tollsimy/Analog-Time-Domain-Step-to-Gaussian-Shaping-Filter/Docs/Charge Sensitive Preamplifier _ PhysicsOpenLab_files/ramanSetup_6-310x165.jpg

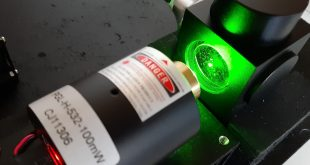
Docs/Charge Sensitive Preamplifier _ PhysicsOpenLab_files/ramanSetup_6-310x165.jpg
