tollsimy/Analog-Time-Domain-Step-to-Gaussian-Shaping-Filter/Docs/Charge Sensitive Preamplifier _ PhysicsOpenLab_files/3778-LfM-Alphaspektrometrie.jpg

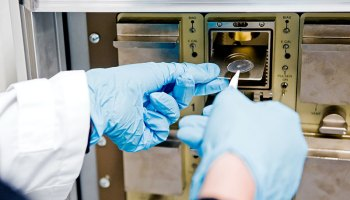
Docs/Charge Sensitive Preamplifier _ PhysicsOpenLab_files/3778-LfM-Alphaspektrometrie.jpg
