tollsimy/Analog-Time-Domain-Step-to-Gaussian-Shaping-Filter/Docs/Charge Sensitive Preamplifier _ PhysicsOpenLab_files/csp2.bmp

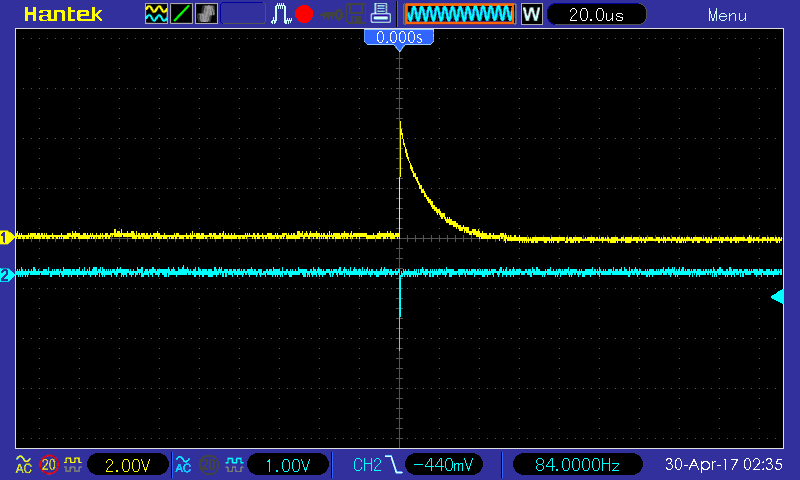
Docs/Charge Sensitive Preamplifier _ PhysicsOpenLab_files/csp2.bmp
