tollsimy/Analog-Time-Domain-Step-to-Gaussian-Shaping-Filter/Docs/Charge Sensitive Preamplifier _ PhysicsOpenLab_files/CSPInput.png

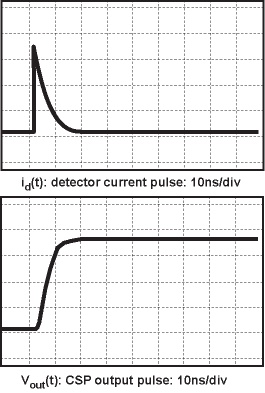
Docs/Charge Sensitive Preamplifier _ PhysicsOpenLab_files/CSPInput.png
