tollsimy/Analog-Time-Domain-Step-to-Gaussian-Shaping-Filter/Docs/Charge Sensitive Preamplifier _ PhysicsOpenLab_files/DEM-OPA-SO-1A.jpg

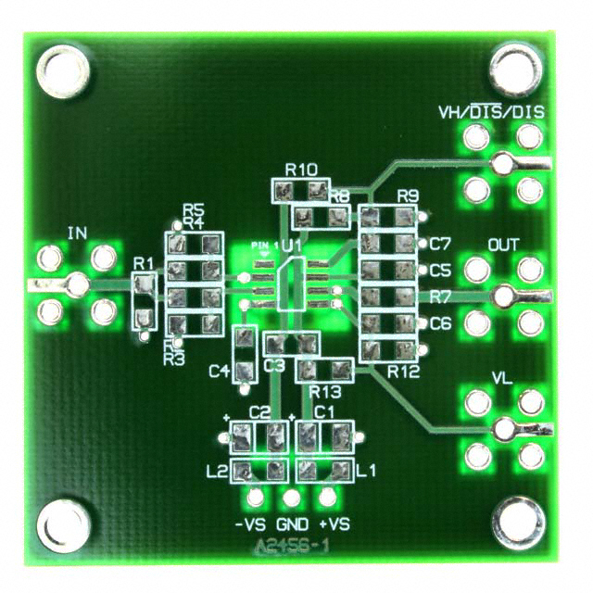
Docs/Charge Sensitive Preamplifier _ PhysicsOpenLab_files/DEM-OPA-SO-1A.jpg
