tollsimy/Analog-Time-Domain-Step-to-Gaussian-Shaping-Filter/Docs/Charge Sensitive Preamplifier _ PhysicsOpenLab_files/IMG_20170415_173511-1024x1012.jpg

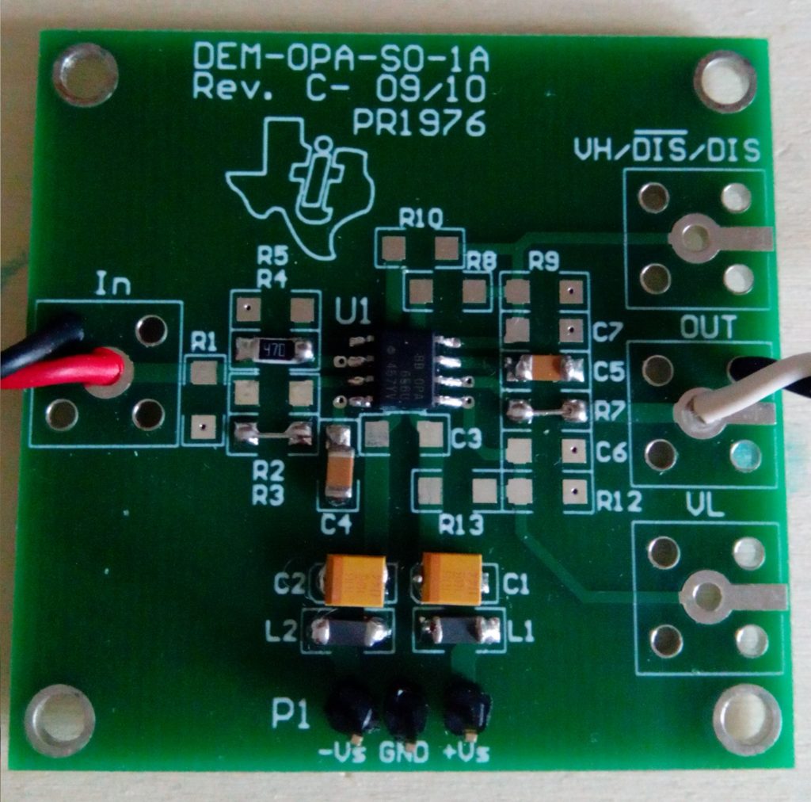
Docs/Charge Sensitive Preamplifier _ PhysicsOpenLab_files/IMG_20170415_173511-1024x1012.jpg
