tollsimy/Analog-Time-Domain-Step-to-Gaussian-Shaping-Filter/Docs/Charge Sensitive Preamplifier _ PhysicsOpenLab_files/IMG_20170427_181501.jpg

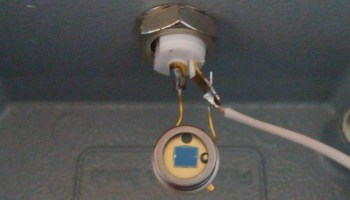
Docs/Charge Sensitive Preamplifier _ PhysicsOpenLab_files/IMG_20170427_181501.jpg
