tollsimy/Analog-Time-Domain-Step-to-Gaussian-Shaping-Filter/Docs/Charge Sensitive Preamplifier _ PhysicsOpenLab_files/IMG_20170617_113114-1024x614.jpg

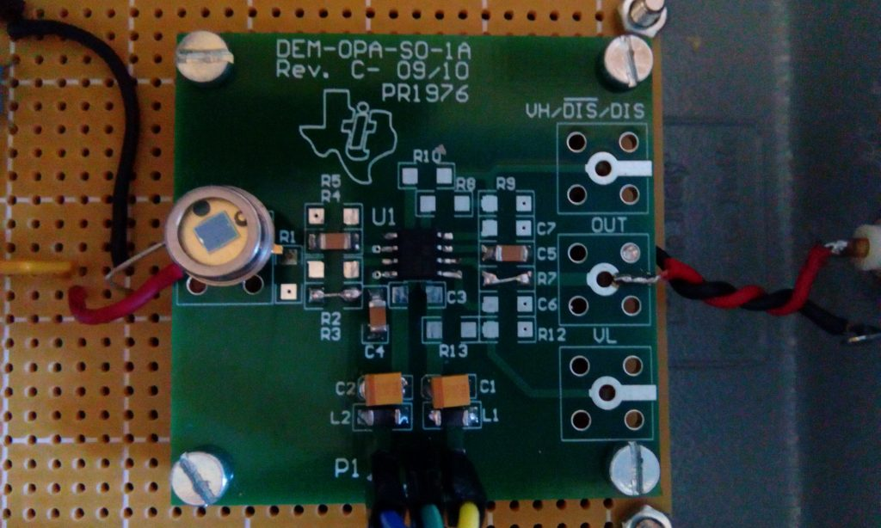
Docs/Charge Sensitive Preamplifier _ PhysicsOpenLab_files/IMG_20170617_113114-1024x614.jpg
