tollsimy/Analog-Time-Domain-Step-to-Gaussian-Shaping-Filter/Docs/Charge Sensitive Preamplifier _ PhysicsOpenLab_files/retroCSP.png

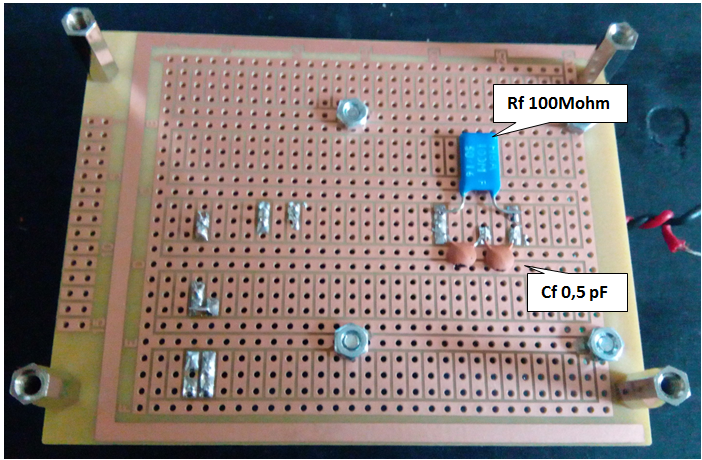
Docs/Charge Sensitive Preamplifier _ PhysicsOpenLab_files/retroCSP.png
