tollsimy/Analog-Time-Domain-Step-to-Gaussian-Shaping-Filter/Docs/Charge sensitive preamplifiers explained – Cremat Inc_files/shaper_effects.jpg

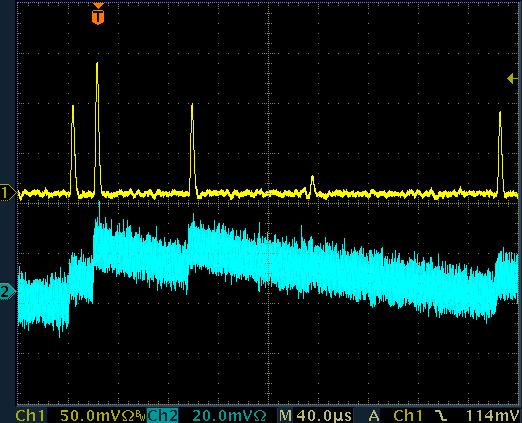
Docs/Charge sensitive preamplifiers explained – Cremat Inc_files/shaper_effects.jpg
