tollsimy/Analog-Time-Domain-Step-to-Gaussian-Shaping-Filter/Pics/IMG_20220221_233307.jpg

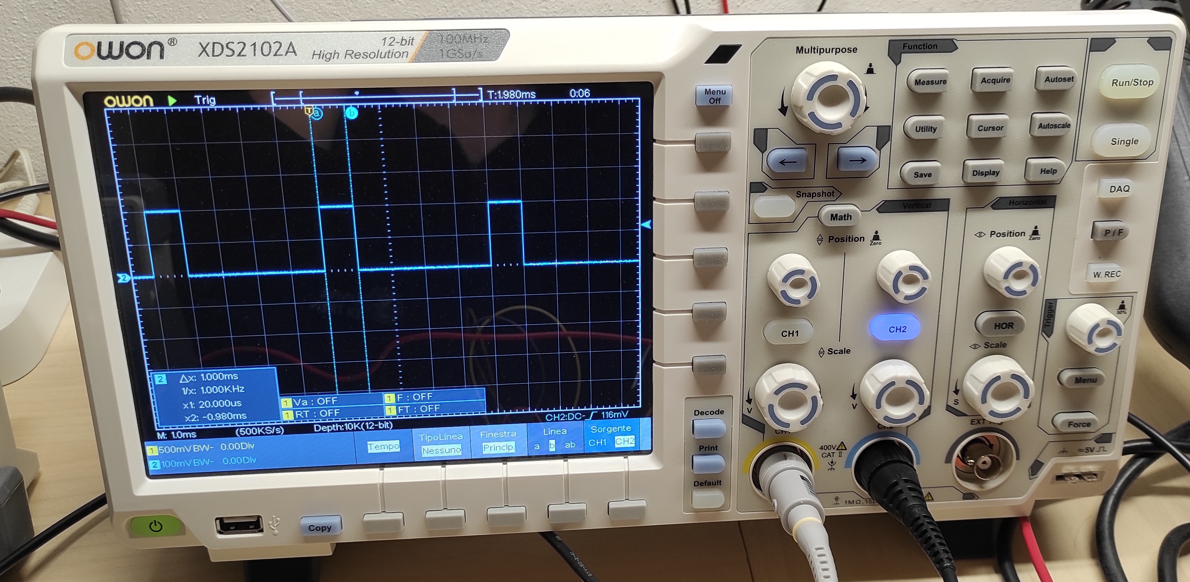
Pics/IMG_20220221_233307.jpg
