tollsimy/Analog-Time-Domain-Step-to-Gaussian-Shaping-Filter/Pics/IMG_20220222_125657.jpg

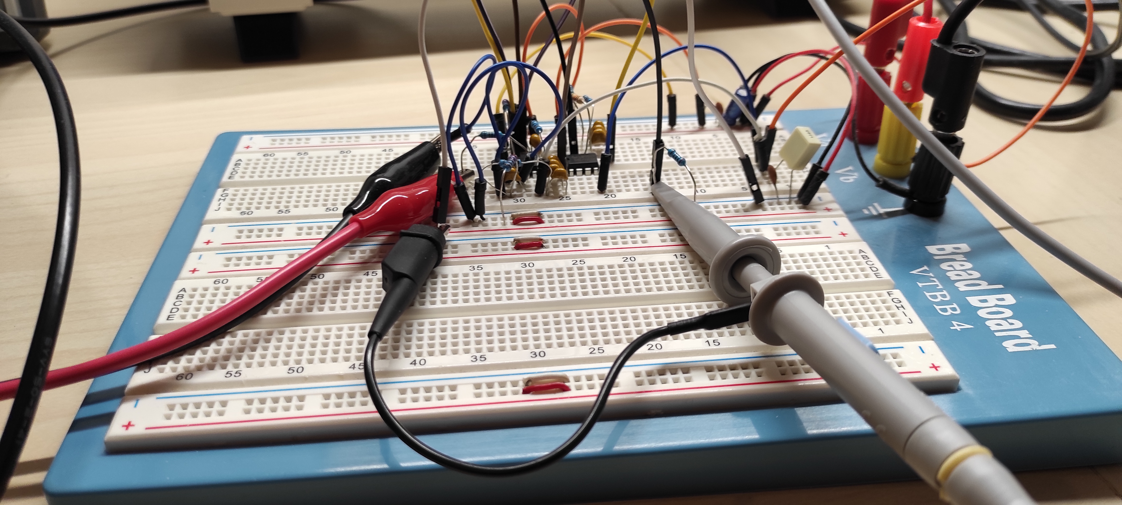
Pics/IMG_20220222_125657.jpg
