tollsimy/Analog-Time-Domain-Step-to-Gaussian-Shaping-Filter/Report/Analog Time Domain Step-to-Gaussian Shaping Filter.pdf

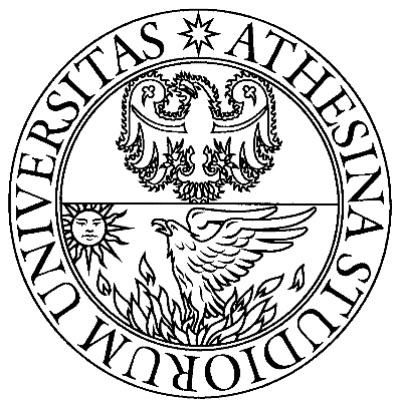
[picture p20: figure]

## Università degli Studi di Trento

## Dipartimento di Ingegneria e Scienza dell’Informazione

## Corso di Fondamenti di Elettronica Analogica

### Titolare del Corso: Prof. Gian Franco Dalla Betta

## “Analog Time Domain Step-to-Gaussian Shaping Filter”

### Studente: Simone Tollardo

### Matricola: 209002

### Anno Accademico 2021/2022

## Index

## What do we mean by “time domain filters”?

In signal processing, a filter is a device or process that removes some unwanted components or features from a signal. We know that every linear time-invariant filter has a Frequency Response and so it can remove or modify some parts of the frequency spectrum of the input signal.
We also know that every linear time-invariant filter has an IRF (Impulse Response Function) that is the inverse LT (Laplace Transform) of the frequency response.
Although frequency response is very useful in a lot of application, sometimes we are interested in the effect that the filter produces in the time domain (or in the spatial domain for the case of Image Processing filters). One example can be image processing filter: we would want to blur an image, so a typical solution is a moving average filter, and its purpose is to replace the pixel level by the average of the level of the near pixels (the number of “near” pixels depends on the chosen window dimension).
This filter is simply a low pass in the frequency domain but in this case we are interested in the spatial domain response. Farther, for digital filters we often have to implement the filter in the time (or spatial) domain as a kernel and then we simply convolute the impulse response of the filter with the input signal. Same rules apply for analog filters, the only “problem” is that we typically think in terms of the frequency response, especially for electronic filters, and making a bidirectional correspondence between frequency domain and time domain isn’t always trivial (without calculators and other mathematical tools).

## What is a “shaping filter”?

In electronics and telecommunications, shaping is the process of changing the waveform of transmitted signal. A typical purpose is to make the transmitted signal better suited to its purpose or the communication channel, typically by limiting the effective bandwidth of the transmission (pulse shaping filter).

The purpose of this project is to find the best way to design a filter that shape a relatively long input step-like signal to a very short gaussian output signal.

So, for this purpose we need a Step Shaping Filter that transform an input step signal to a Gaussian shape output signal.

## How can we obtain a gaussian shape from a step shape?

A Gaussian filter is a filter whose impulse response is a Gaussian function. Gaussian filters are designed to give no overshoot to a step function input while minimizing the rise and fall time. This behaviour is closely connected to the fact that the Gaussian filter has the minimum possible group delay. Mathematically, a Gaussian filter modifies the input signal by convolution with a Gaussian function; this transformation is also known as the Weierstrass transform.

Considering that we want the step response to be a gaussian, and not the impulse response as in the case of a gaussian filter, we can derive the wanted impulse response of our system in this way:
We know that for a linear time-invariant (LTI) system the step response a(t) can be obtained by the integral of the impulse response ℎ(t) of the system itself:

a(t) = ∫ ℎ(t)

t

0

dt

Moving into frequencies domain: A(jω) =

G(jω)
jω

, where G(jω) is the frequency response of the system for real frequencies.

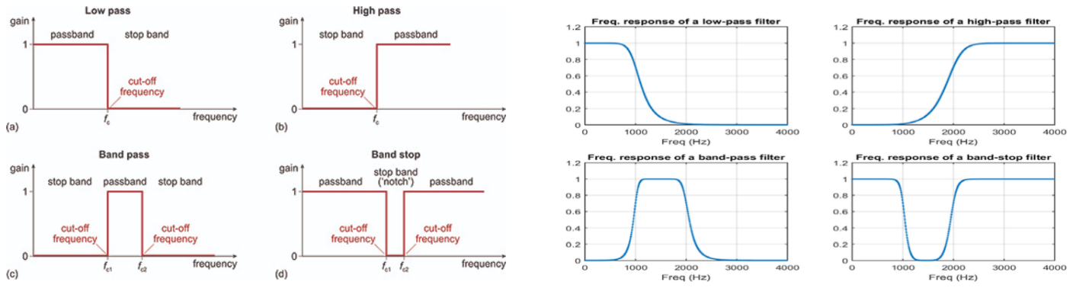
[picture p21: figure]

Fig. 2 – Real Filters response.

If we want a(t) to be Gaussian, it can be proven that also A(jω) must be Gaussian. (Fourier transform of a

Gaussian is a Gaussian: if for example, we apply the Fourier Transform to a gaussian g(t) = σe

−

1/2 σ

2
t

2
, we

get G(jω) = σe

−(

ω2
2σ2

)
.)

Hence, our frequency response G(jω) is a Gaussian multiplied by jω:

G(jω) = (jω)σe

−(

ω2
2σ2

)
and its corresponding transfer function is G(s) = sσe

−(
s

2
2σ2

)

How can we obtain a transfer function that has G(s) = sσe

−(
s

2
2σ2

)
response?
We know that the transfer function of a LTI system can be always written as:

H(s) =

(s − z1

)(s − z2

) ⋯ (s − zn

)
(s − p1

)(s − p2

) ⋯ (s − pm)

=

∏ (s − zi
)

n
i=1
∏ | (s − pi
m | ) i=1
where zi | are Zeroes and pi | are Poles of the function.
Since G(s) is a transcendental function, it can not be written as a rational function, so we need to approximate it as a polynomial.

# Types of filters

We know that we can classify a filter for his frequency response in 5 categories:

- Low-Pass filters – high frequencies passed, low frequencies are attenuated
- High-Pass filter – low frequencies passed, high frequencies are attenuated
- Band-Pass filters – only frequencies in a specific band are passed
- Band-Stop filters – only frequencies in a specific band are attenuated
- All-Pass filters – all frequencies are passed, but the phase of the output signal is modified

We know also that it’s impossible to make an ideal filter with an infinitely steep frequency response because it would be infinitely long in the time domain.

Fig. 1 – Ideal Filters response.

Another different classification can be made in terms of the approximation used and the principal classes and characteristics are:

- Butterworth filter – no gain ripple in pass band and stop band, slow cut-off
- Chebyshev filter (Type I and Type II) – no gain ripple in stop band, moderate cut-off
- Bessel filter – no group delay ripple, no gain ripple in both bands, slow gain cut-off

Note the relation between the variance in the time domain Gaussian and the frequency response: as the Gaussian shrinks in time, the shape in the frequency domain gets larger!

- Elliptic filter – gain ripple in pass and stop band, fast cut-off
- Gaussian filter – no ripple in response to step function
- Raised-cosine filter

Each family of filters can be specified to a particular order. The higher the order, the more the filter will approach the "ideal" filter. Note also that the longer the impulse response is and the longer the latency will be. An ideal filter has full transmission in the pass band, complete attenuation in the stop band, and an abrupt transition between the two bands, but this filter has infinite order (i.e., the response cannot be expressed as a linear differential equation with a finite sum) and infinite latency.

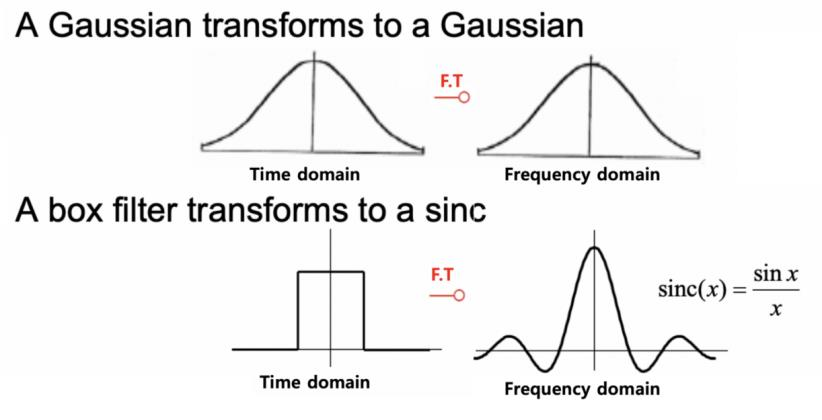
[picture p22: figure]

Fig 3 - Ideal Gaussian filter and ideal Box Filter impulse and magnitude of frequency responses, all infinitely long. (apart from Box).

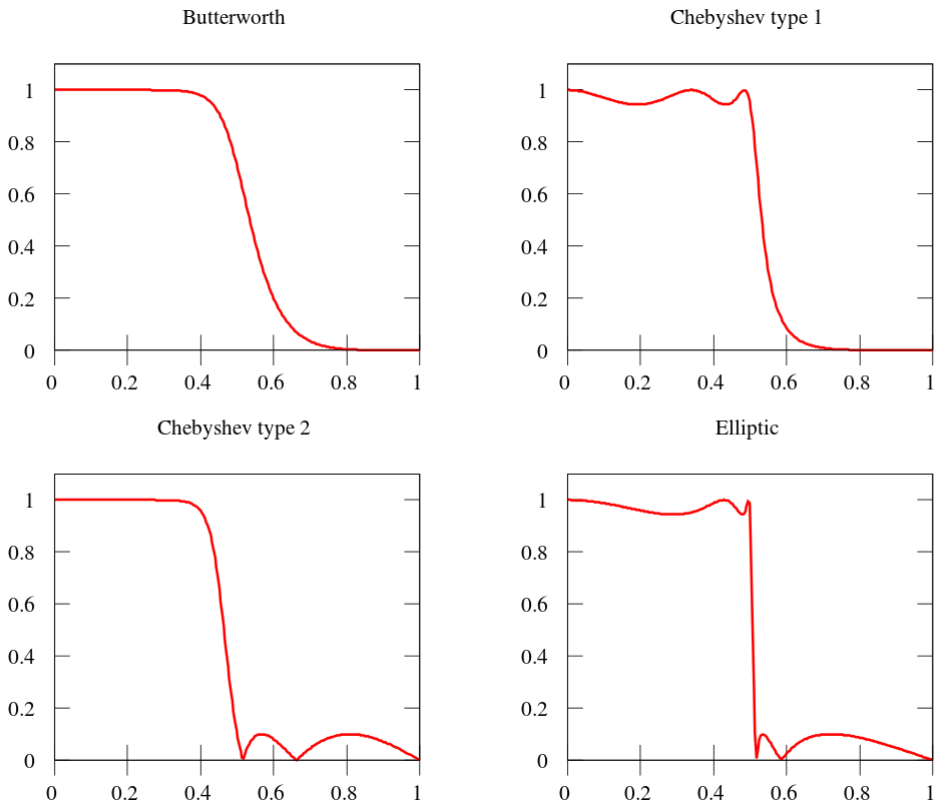
[picture p23: figure]

Fig 4 - Fifth order real low-pass filters comparison (Magnitude of Frequency response).

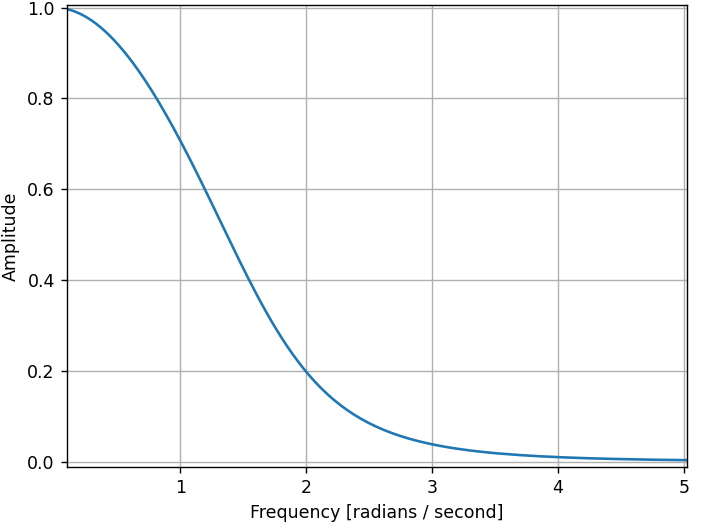
[picture p24: figure]

Fig 5 - Frequency response of real fifth order low-pass Bessel filter (ωc = 1 rad/s).

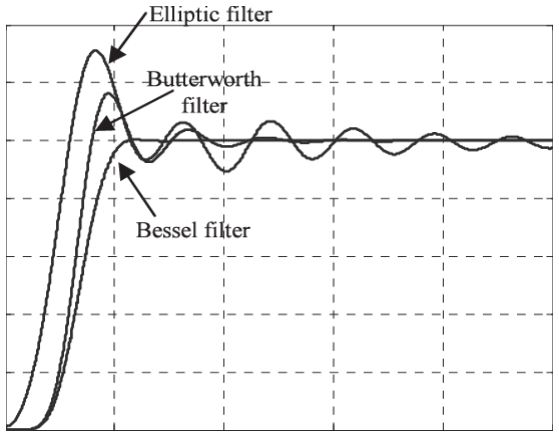
[picture p25: figure]

Fig. 7 – Comparison between real low-pass filters Step response.

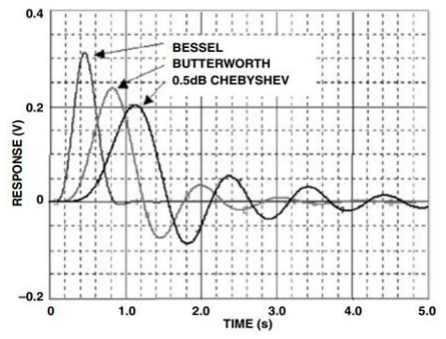
[picture p26: figure]
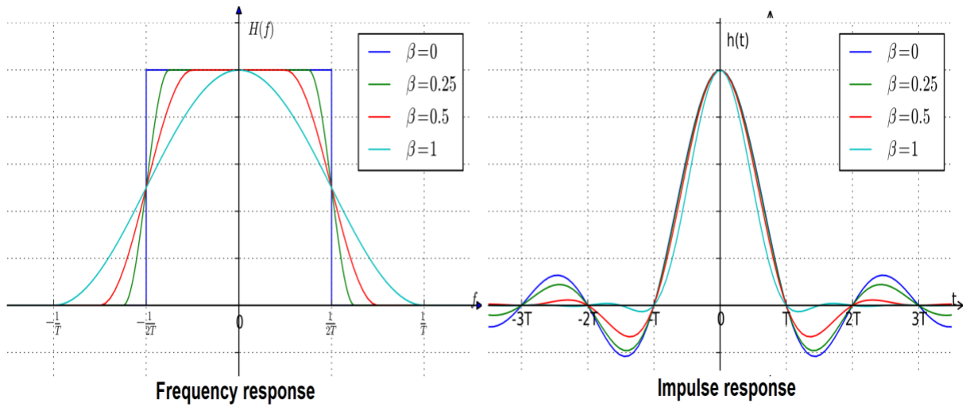
[picture p27: figure]

Fig 8 - Frequency response and impulse response of a real (beta>0) and ideal (beta=0) low-pass Raised-Cosine filter.

* Usually, Chebyshev and Elliptic filters’ cut-off frequency is defined as the frequency at which the response falls below the ripple band.

Fig 6 - Comparison between real low-pass filters Impulse response.

NOTE: a Butterworth filter can always be designed to have a frequency response gain like this:

G(ω) =

1
√1 + (
ω
ωc

)

2n

where ω is the angular frequency in radians per second and n is the number of poles in the filter.
If ω = ωc
, the amplitude response of this type of filter in the passband is 1/√2 ≈ 0.707, which is half power or −3 dB.
ωc
is commonly called “cut-off frequency”.
For clarity, in this document, when we refer to cut-off frequency, for any type of filter, we refer to the frequency at which the gain is 1/√2 before dropping.* (“normalized cut-off frequency”)

# Approximation comparisons

I did a comparison between the magnitude of some types of approximation here: https://www.desmos.com/calculator/et3dns7k9l

NOTE: I immediately discarded Elliptic, Chebyshev and Butterworth filter for the comparison because of the evident overshoot in their step responses.

Let’s discuss the results:

For simplicity I rewrote the two gaussian as:

g(t) = σe

−

x

2

2σ2

2
, time domain gaussian, and G(s) = σxe

−

x

2
2σ2

frequency response, where σ =

1
σ2
(Note the inverse proportionality between σ1 and σ2)
These are the time domain gaussian centred in t = 0 and with standard deviation σ2 =

1
σ

≅ 0. 78, in

blue, and the corresponding frequency domain response modulus (the one that we are trying to approximate), in black:

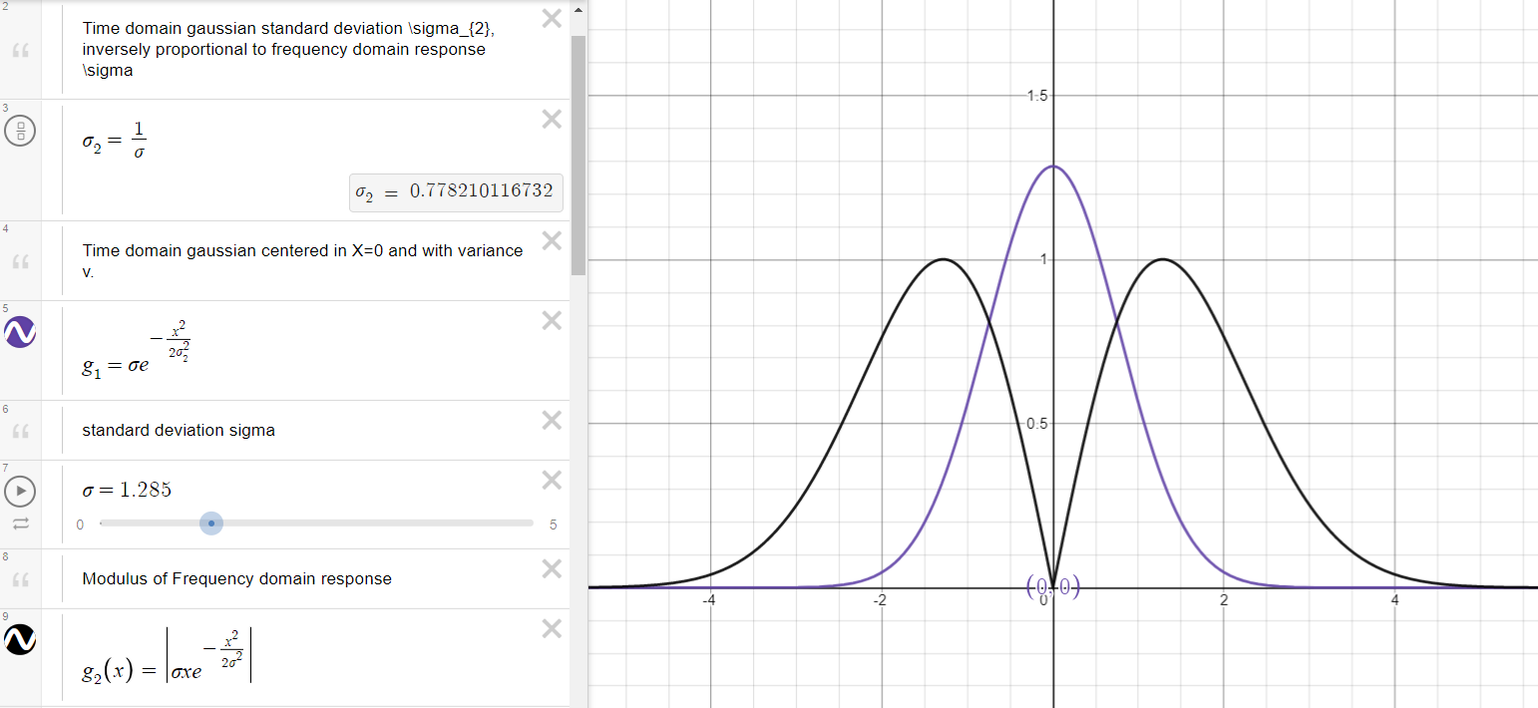
[picture p28: figure]

gaussianwidth.mp4
errata:(not scaled by 1/sigma)

# Taylor approximation

We can approximate G(s) transfer function developing it into a Taylor power series:

Considering only first 7 terms we get:

T(s) = (x −
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
This is the comparison between Taylor approximation of the response with the response itself:

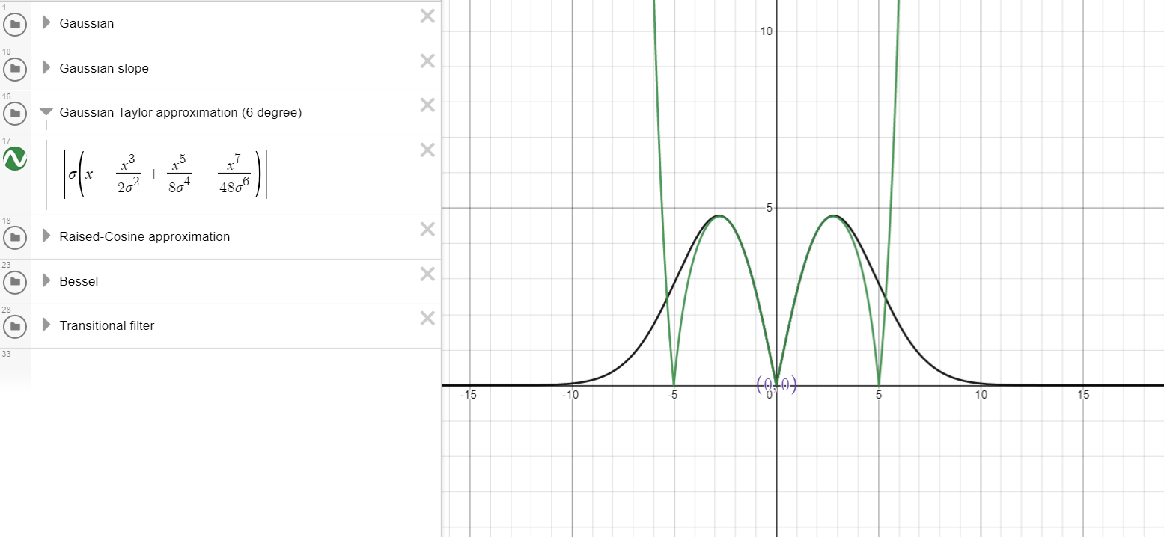
[picture p29: figure]

# Raised-Cosine approximation

Raised-cosine filter (Fig. 8) is another type of pulse shaping filter, commonly used in digital filters.
The raised-cosine filter is a frequently used pulse-shaping filter, often in digital modulation, due to its ability to minimise intersymbol interference (ISI). Its name stems from the fact that the non-zero portion of the frequency spectrum of its simplest form (β = 1) is a cosine function, 'raised' up to sit above the
f (horizontal) axis.

This is the comparison between our transfer function and a raised-cosine function centred in x1 = 1.2 and with maximum value y(1.2) = 0.8:

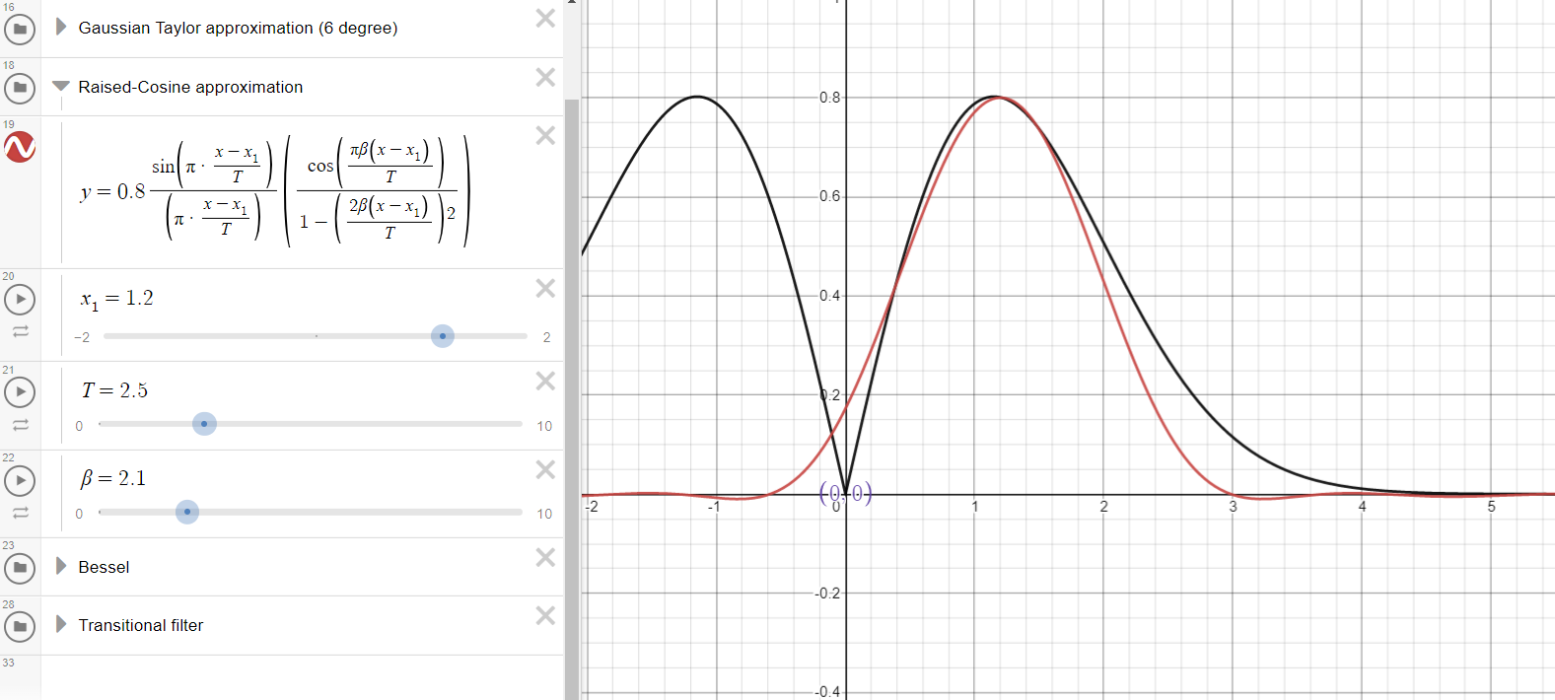
[picture p30: figure]

raised-cosine.mp4

Although Raised-Cosine function could be a good approximation of our frequency response, it’s not a rational function so we can not directly implement it as a transfer function.

# Bessel approximation

Another way to approximate our G(s) is using Bessel approximation.
The Bessel filter is very similar to the ideal Gaussian filter (as said before it’s a filter whose impulse response is a gaussian function) and tends towards the same shape as filter order increases (again, remember that Fourier transform of a Gaussian is a Gaussian). While the time-domain step response of the ideal Gaussian filter has zero overshoot, the Bessel filter has a small amount of overshoot but, as we can clearly see in the Fig. 6 and Fig. 7, still much less than common frequency domain filters.

Compared to finite-order approximations of the Gaussian filter, the Bessel filter has better shaping factor, flatter phase delay, and flatter group delay than a Gaussian of the same order, though the Gaussian has lower time delay and zero overshoot.
Note that the transition from the pass band to the stop band is much slower than for other filters, but the group delay is practically constant in the passband.
(Group delay D(w) ≡ −

d
dt

θ(w) ; where θ(w) is bode phase response. For linear phase responses, i.e., Θ(ω) = −αω for some constant α, the group delay and the phase delay are identical, and each may be interpreted as time delay. If the phase response is nonlinear, then the relative phases of the sinusoidal signal components are generally altered by the filter. A nonlinear phase response normally causes a “smearing” of attack transients.)

I computed the absolute value of Bessel functions (both Low Pass and High Pass, one for the first half of the shape and the second for the second half), and after some parametrical test, I found out that the best approximation is when our G(s) is scaled by a factor β =

1.285
σ

(in order to keep peak at a constant value of about 0.78). For example, if σ = 2.57 we should have G1

(s) = 0.5 ∗ G(s).

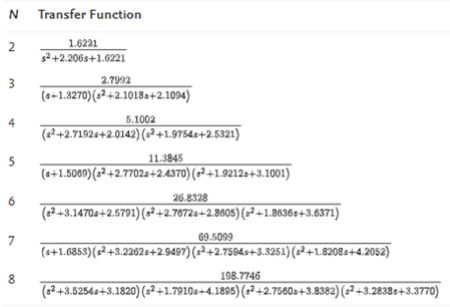
[picture p31: figure]

Bessel functions for a LP filter.

This, for example is the comparison between our G1

(s) for σ = 2.57 (in black) and Bessel approximations. I used an 3° order LP Bessel filter response (in red) for the second half of the shape and a 1° order HP filter response (in blue) (first order response are all the same, doesn’t matter what approximation you use) for the first part of the shape:
(cut-off frequency are respectively ωcℎ = 3.3 rad/s and ωcl = 1.9 rad/s)

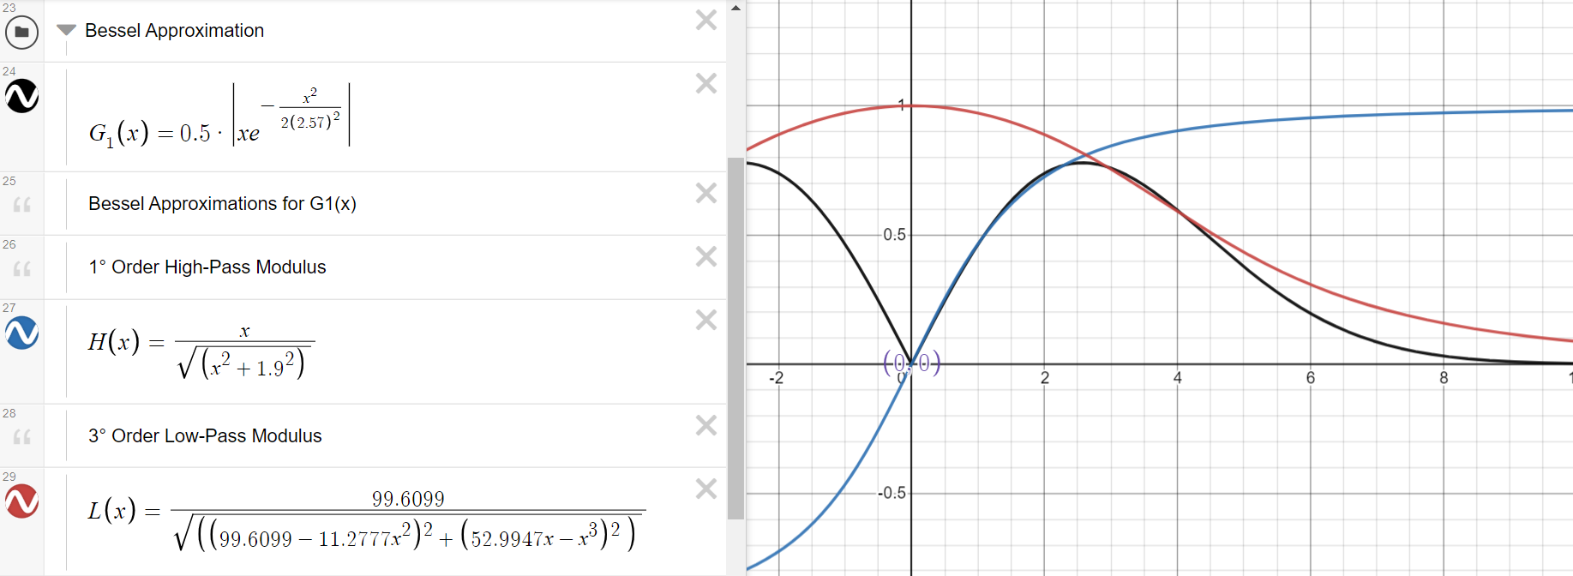
[picture p32: figure]

This is the same result on a Bode plot (magnitude only):

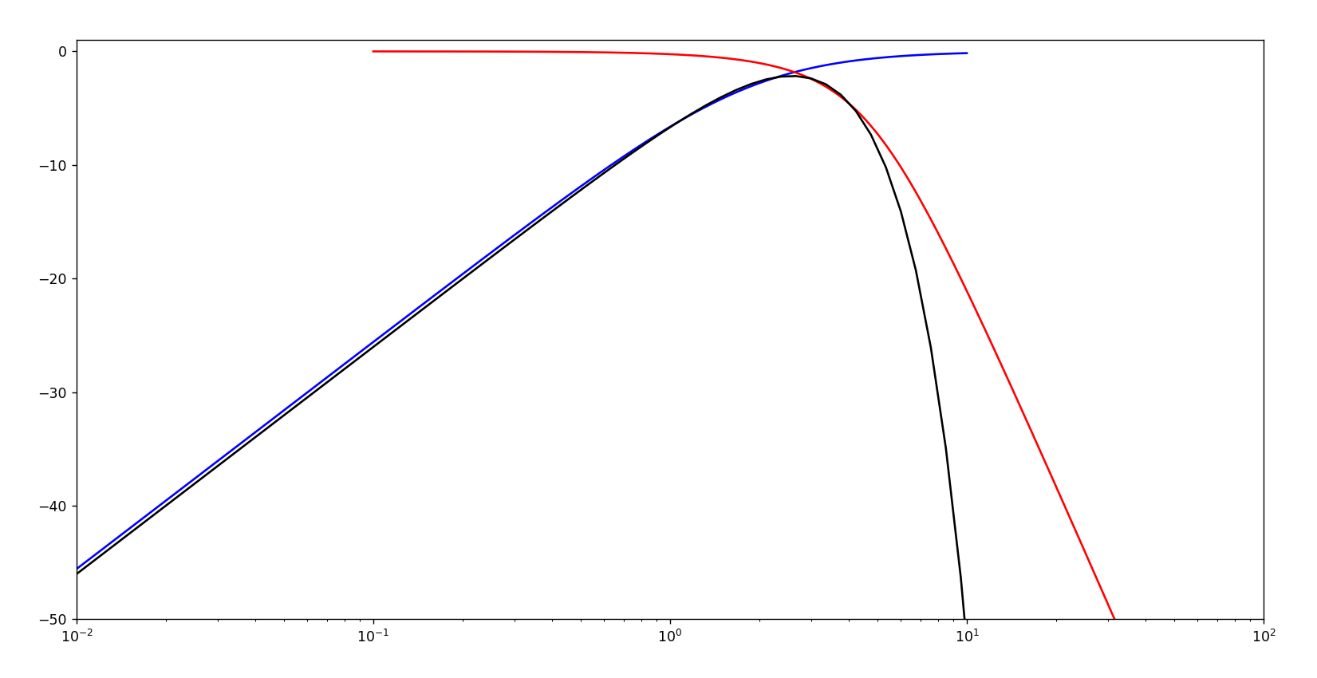
[picture p33: figure]

As we can see Bessel approximation is really good and doesn’t add much complexity, in fact even 3° order + 1° order filters should satisfy our requirements.

This is the python code used for the Bode plot:

import numpy as np
import matplotlib.pyplot as plot from scipy import signal

fig1, ax1 = plot.subplots()
b, a = signal.bessel(1,1.9,"high", analog=True,norm="mag") w, h = signal.freqs(b,a)
ax1.semilogx(w,20*np.log10(abs(h)),color="blue")
b, a = signal.bessel(3,3.3,"low", analog=True,norm="mag") w, h = signal.freqs(b,a)
ax1.semilogx(w,20*np.log10(abs(h)),color="red") expr="x*(0.5*np.e**((-x**(2))/(2*(2.57**(2)))))" x=np.logspace(-2,3,100)

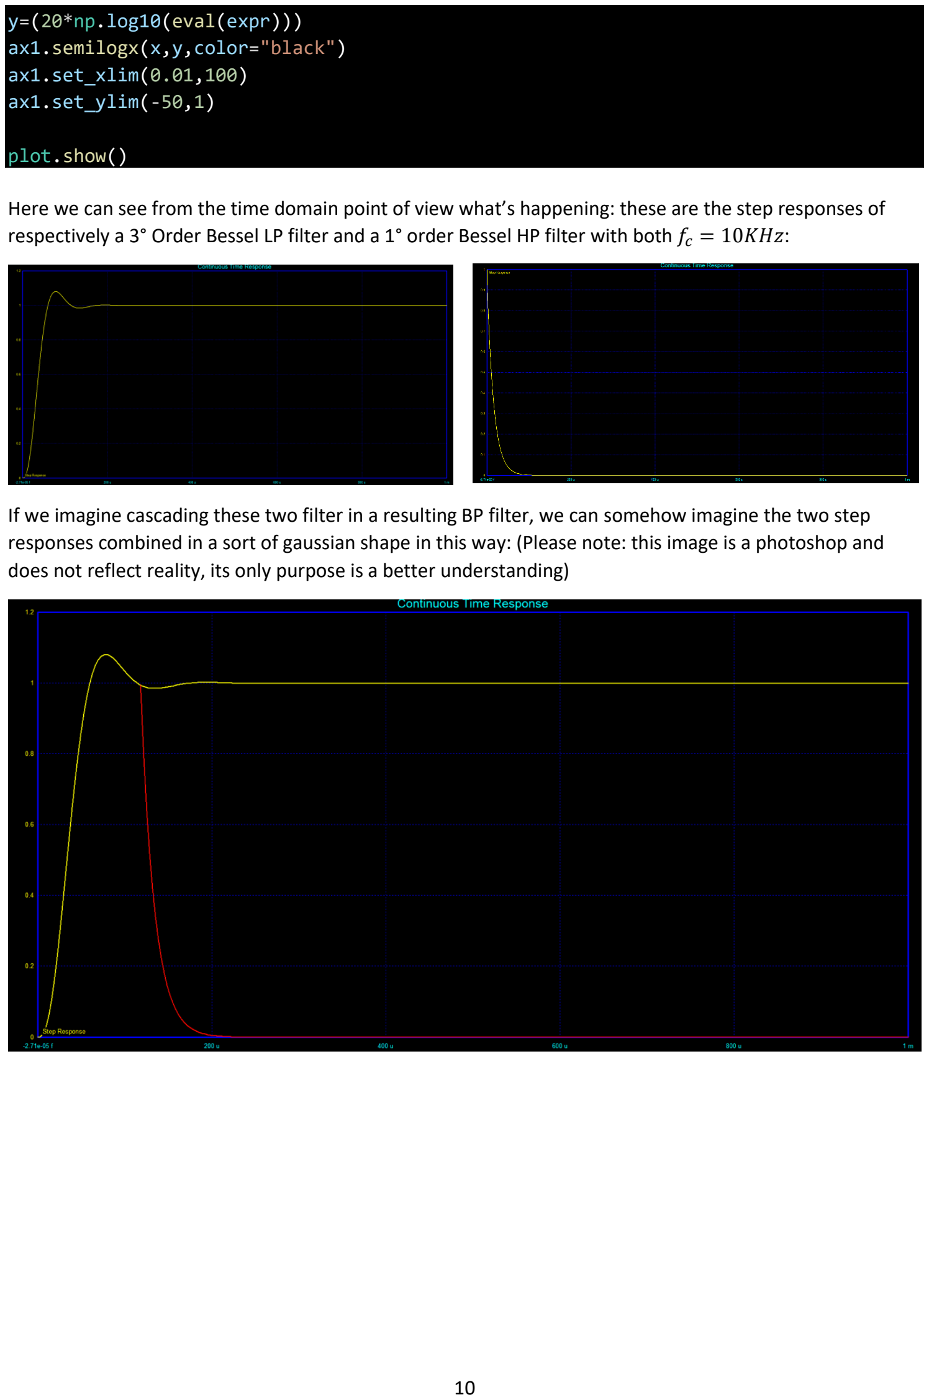
[picture p34: page 11]

y=(20*np.log10(eval(expr))) ax1.semilogx(x,y,color="black") ax1.set_xlim(0.01,100)
ax1.set_ylim(-50,1)

plot.show()

Here we can see from the time domain point of view what’s happening: these are the step responses of respectively a 3° Order Bessel LP filter and a 1° order Bessel HP filter with both fc = 10KHz:

If we imagine cascading these two filter in a resulting BP filter, we can somehow imagine the two step responses combined in a sort of gaussian shape in this way: (Please note: this image is a photoshop and does not reflect reality, its only purpose is a better understanding)

# Transitional filters

Another approximation can be made using so called “Transitional Filters”.

A transitional filter is a compromise between an ideal Gaussian filter and the Chebyshev. A transitional filter has nearly linear phase shift and smooth, monotonic roll-off in the pass band. Above the pass band there is a break point beyond which the attenuation increases dramatically compared to the Bessel, and especially at higher values of n (filter order). We can commonly find two tables of transition filters: these are the Gaussian to 6 dB and Gaussian to 12 dB.

The Transitional Gaussian to 6 dB filter has better transient response than the Butterworth in the passband. Beyond the break point, which occurs at ωr = 2 rad/s (roll-off frequency/pulsation) for a ωc = 1 rad/s filter, the roll-off is similar to the Butterworth.

The Transitional Gaussian to 12 dB filter's transient response is much better than Butterworth in the passband. Beyond the 12 dB break point, which occurs at ωr = 2 rad/s for a ωc = 1 rad/s filter, the attenuation is less than the Butterworth.

For Transitional filters, pole locations do not have a closed form method for computation.

Using poles tables (you can find them easily on the web) I calculated the frequency response of a 3° order Transitional 6dB Gaussian filter:
(original gaussian in black, 3° Order Gaussian 6dB filter in red, 1° Order filter in blue)

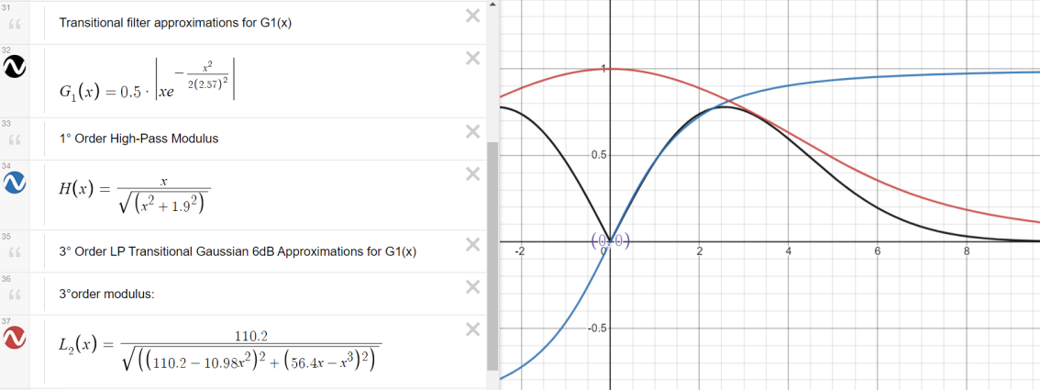
[picture p35: figure]

Same results on a Bode plot (magnitude only):

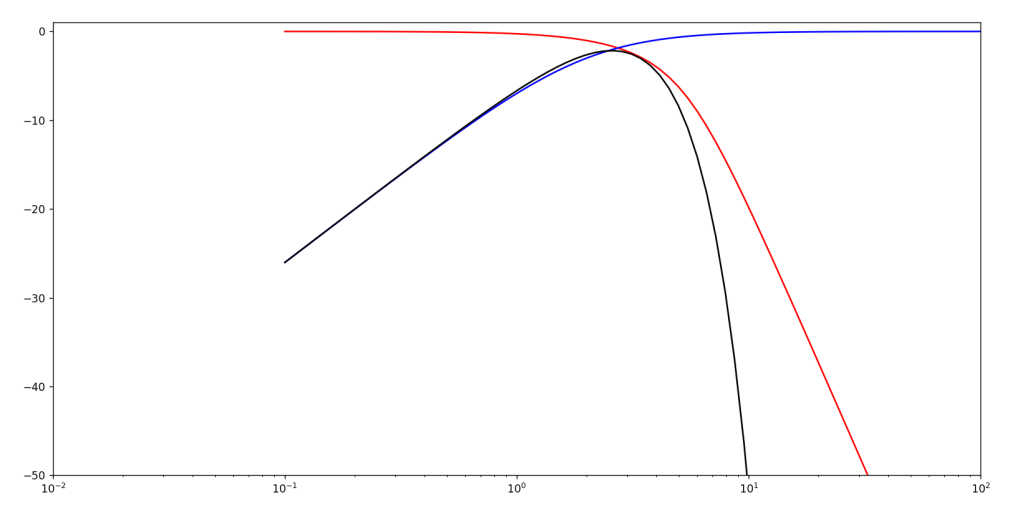
[picture p36: figure]

As we can see, Transitional filter Gaussian 6dB and Bessel filter have almost same response.

After all these comparisons we can say that for approximating the first half of our wanted frequency response we simply need a 1° order HP filter, while for the second half we need a higher order filter like Bessel or Transitional filters (and the higher the order the better the approximation is).
In fact, overshoot for of step response decreases as filter order increases for a LP filter, while decreases as filter order decreases for an HP filter.
For convenience reasons (because it’s better documented and easily computable) I will chose Bessel filter for this project.

Example of frequency response (magnitude) of increasing order low-pass Bessel Filters (from 1 to 10) with ωc = 3.3 rad/s vs the previous discussed gaussian (in black) and the corresponding impulse responses.

increasingorderbesse
lLP.mp4

This is the python code used for these plots:

import functools
import numpy as np
import matplotlib.pyplot as plot from scipy import signal

def plotlive(func):
plot.ion()
@functools.wraps(func)
def new_func(*args, **kwargs): result = func(*args, **kwargs) plot.draw()
plot.pause(1)
return result
return new_func

@plotlive
def plot_something_live(ax, x, y): ax.plot(x, y)

#setting plots

plot.ion()
fig1, (ax1,ax2) = plot.subplots(1,2) mng = plot.get_current_fig_manager() mng.resize(1200,600)
ax1.set_title("Frequency response") ax1.set_xlabel("Angular frequency [rad/s]") ax1.set_ylabel("Gain [dB]") ax2.set_title("Impulse response") ax2.set_xlabel("Time [S]") ax1.set_xlim(0.1,100)
ax1.set_ylim(-120,1)

#gaussian with variance 1.15

expr="x*(0.5*np.e**((-x**(2))/(2*(2.57**(2)))))" x=np.logspace(-1,3,1000)
y=20*np.log10(eval(expr))
ax1.semilogx(x,y,color="black")

for i in range(10):
b, a = signal.bessel(i+1,3.3,"low", analog=True,norm="mag") w, h = signal.freqs(b,a)
plot_something_live(ax1, w, 20*np.log10(abs(h)))
t2, v2 = signal.impulse((b,a))
plot_something_live(ax2, t2, v2)

Obviously, if our gaussian become larger in time domain (σ2 increases) the frequency domain’s gaussian shape become shorter (σ decreases) and vice-versa, so for best approximation we need a lower/higher cut-off frequency ωc
to follow the curve.

Here is an example: in grey we can see our frequency response G(s) with standard deviation σ2 = 2.57 while in black another with σ2 = 25.7. In order to approximate the gaussian I plotted the frequency and impulse responses of two 8° order Bessel filters LP filters (one impulse response is scaled in amplitude in order to properly see it), one with ωc = 3.3Hz (in blue) and one with ωc = 33Hz (in red):

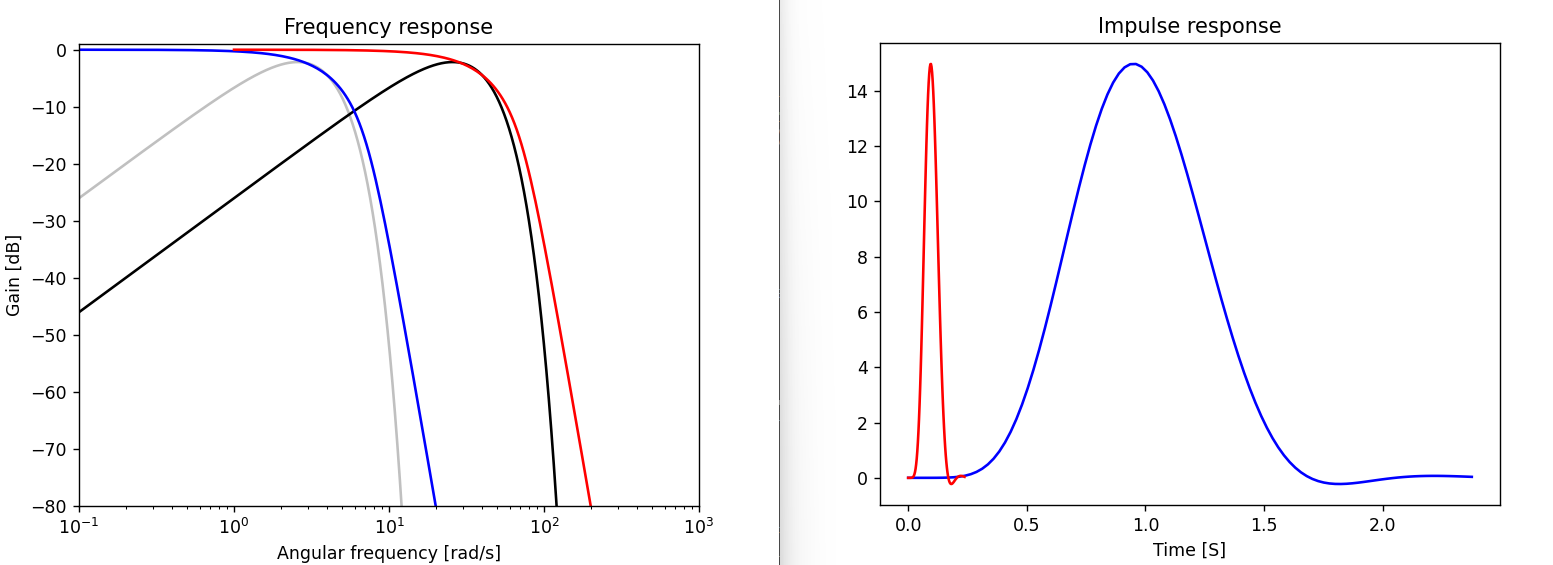
[picture p37: figure]

Obviously, same consideration applies for the HP filter.

NOTE: How can we obtain the frequency response of a HP filter from a LP filter with the same cut-off frequency?

We can transform a LP filter to a HP filter simply considering that the transfer function of a LP filter is the transfer function of a HP filter with s replace by 1
s

. (Intuitively, remember that LP perform a time domain integration, that is a multiplication by s in the Laplace domain)

So, if for example our LP filter transfer function is GLP(s) =

1
s

3+2.433s

2+2.467s+1

, our HP filter transfer

function will be GHP(s) =

s

3
1+2.433s+2.467s

2+s

3

Again, this is the python script used: import functools
import numpy as np
import matplotlib.pyplot as plot from scipy import signal

def plotlive(func):
plot.ion()
@functools.wraps(func)
def new_func(*args, **kwargs): result = func(*args, **kwargs) plot.draw()
plot.pause(1)
return result
return new_func

@plotlive
def plot_something_live(ax, x, y): ax.plot(x, y)

#setting plots

plot.ion()
fig1, (ax1,ax2) = plot.subplots(1,2) mng = plot.get_current_fig_manager() mng.resize(1200,600)
ax1.set_title("Frequency response") ax1.set_xlabel("Angular frequency [rad/s]") ax1.set_ylabel("Gain [dB]") ax2.set_title("Impulse response") ax2.set_xlabel("Time [S]") ax1.set_xlim(0.1,100)
ax1.set_ylim(-120,1)

#gaussian with variance 1.15 expr="x*(0.5*np.e**((-x**(2))/(2*(2.57**(2)))))" x=np.logspace(-1,3,1000)

y=20*np.log10(eval(expr))
ax1.semilogx(x,y,color="black")

for i in range(10):
b, a = signal.bessel(i+1,3.3,"low", analog=True,norm="mag") w, h = signal.freqs(b,a)
plot_something_live(ax1, w, 20*np.log10(abs(h)))
t2, v2 = signal.impulse((b,a))
plot_something_live(ax2, t2, v2)

### Observation:

What happens if we want to approximate a shape whose slope is even less steep than the first order filter slope? How can we implement an analog filter that has less than the asymptotic -20dB/dec slope?

# Fractional order filters

The answer is “Fractional Filters”: these filters are modelled by fractional-order systems and they are based on fractional order elements, which are usually approximated with conventional, lumped-element circuits.

In the fields of dynamical systems and control theory, a fractional-order system is a dynamical system that can be modelled by a fractional differential equation containing derivatives of non-integer order. Such systems are said to have fractional dynamics. Derivatives and integrals of fractional orders are used to describe objects that can be characterized by power-law nonlocality, power-law long-range dependence or fractal properties. Fractional-order systems are useful in studying the anomalous behaviour of dynamical systems in physics, electrochemistry, biology, viscoelasticity and chaotic systems.

# Example

The simplest example of a fractional-order filter is the LC ladder filter (in this case in Foster I topology). Here is a spice simulation of a LP and a HP passive LC Ladder fractional filters, all R and C values are calculated using the MatLab script provided in [15].

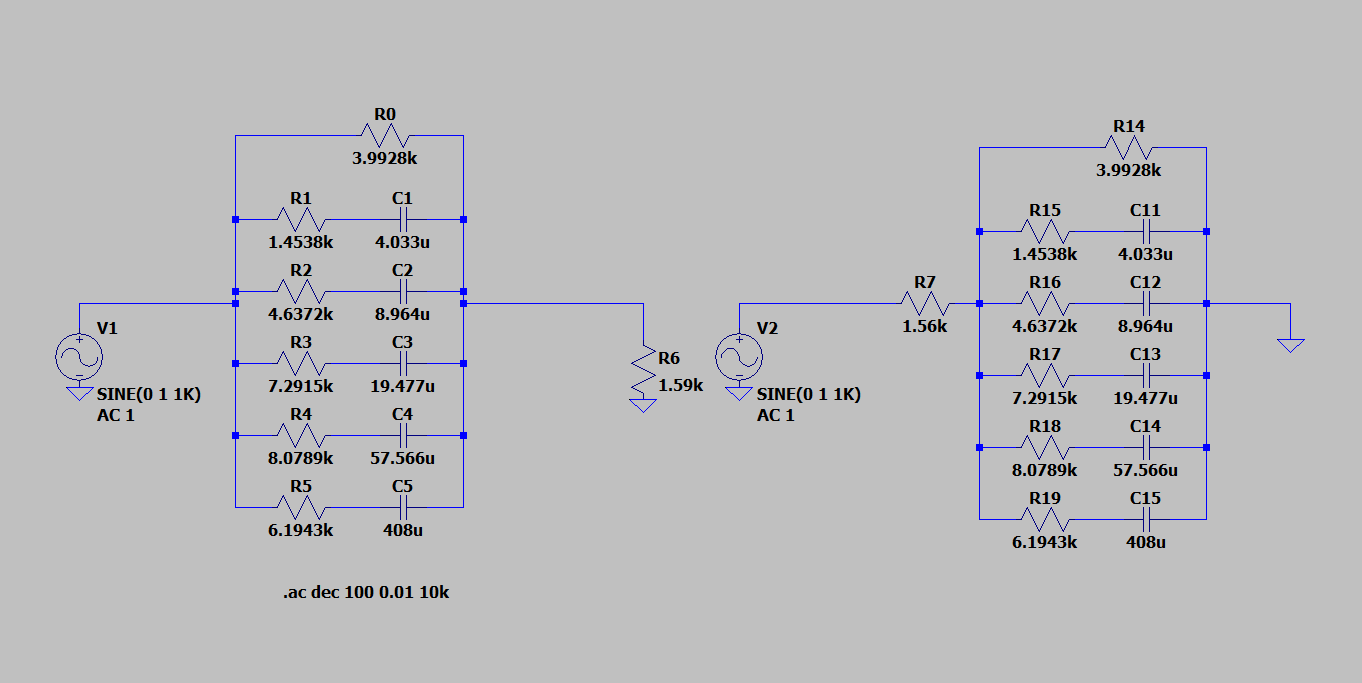
[picture p38: figure]

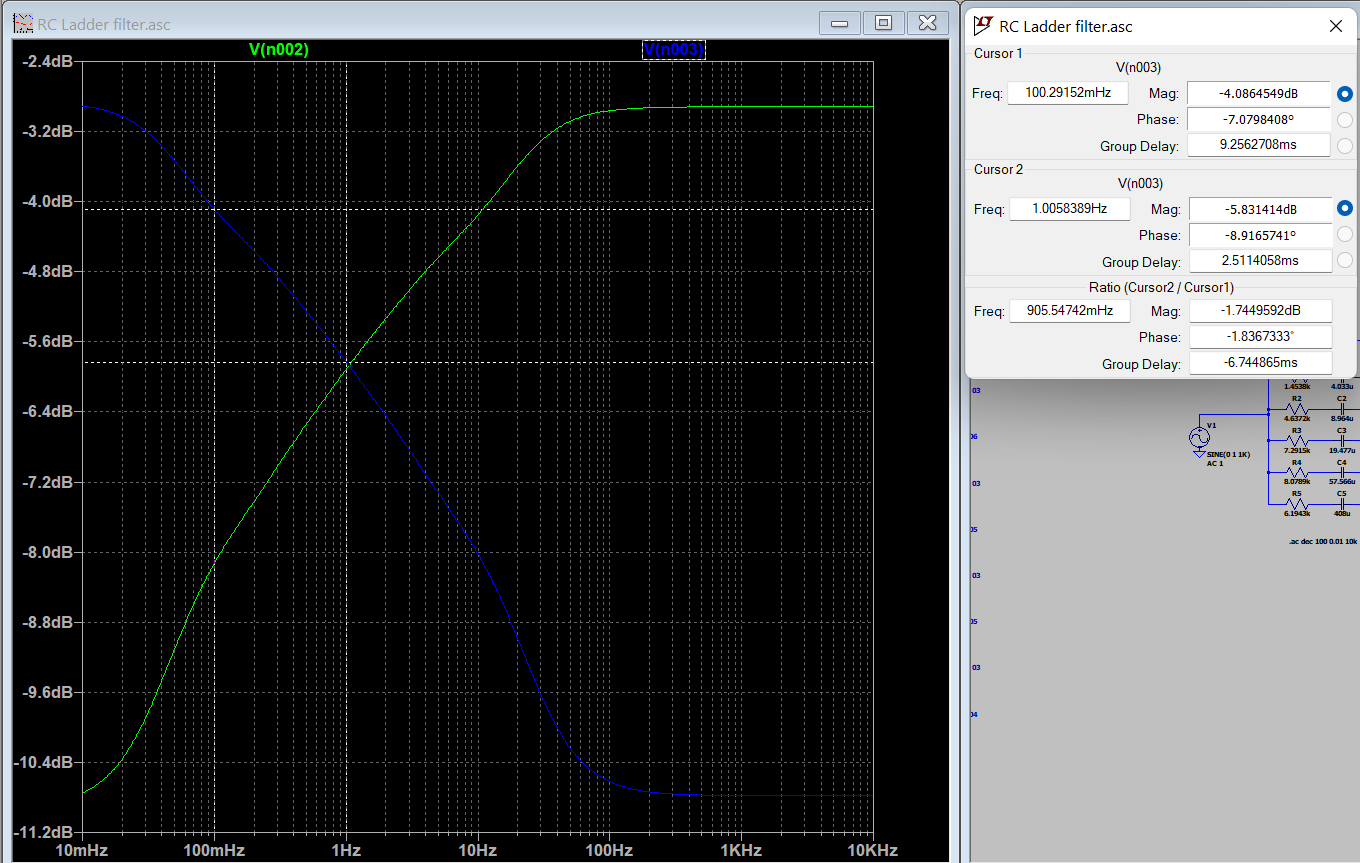
[picture p39: figure]

# Implementation topologies

While transfer function defines the characteristics of the filter, the topology defines the electronic circuit of the filter. Filter topologies may be divided into passive and active types. Passive topologies are composed exclusively of passive components: resistors, capacitors, and inductors. Active topologies also include active components (such as transistors, op amps, and other integrated circuits) that require power.

There are a lot of different types of analog filter topologies, the principals are:

Passive topologies:

- Ladder topologies
- Modified ladder topologies (Usually the design applies some transform to a simple ladder topology)
- Bridged-T and Zobel Networks topologies

Active topologies:

- Multiple feedback topology (MFB)
- Biquad filter topology:
1. Tow-Thomas filter
2. Akerberg-Mossberg filter

As we can see the slope of these HP and LP filters is more or less -2dB/dec!

Another simple example of (active) fractional filter is the fractional-order integrator.
The fractional-order integrator is a modification of the standard integrator circuit, where a capacitor is used as the feedback impedance on an op. amp. By replacing the capacitor with an RC Ladder circuit, we can obtain a fractional-order integrator.

- Sallen–Key topology
- Switched capacitors topology

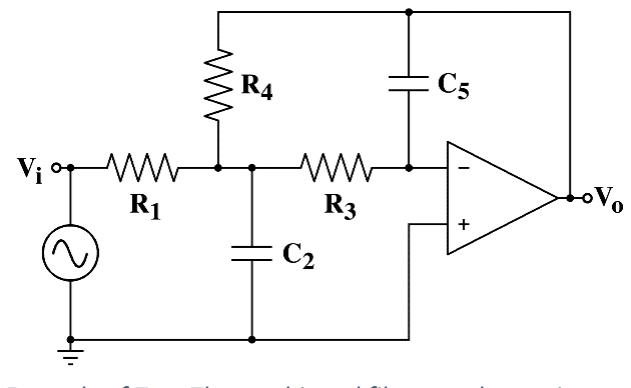
[picture p40: figure]

Example of Multiple Feedback topology using op. amp.

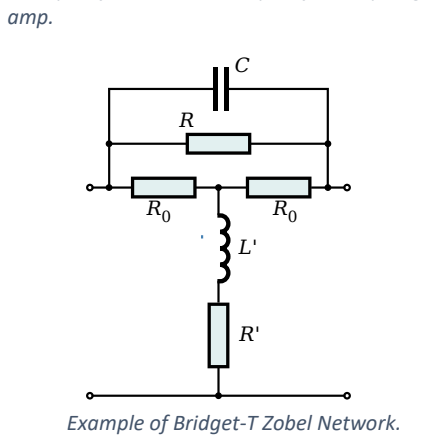
[picture p41: figure]
amp.; Example of Bridget-T Zobel Network.
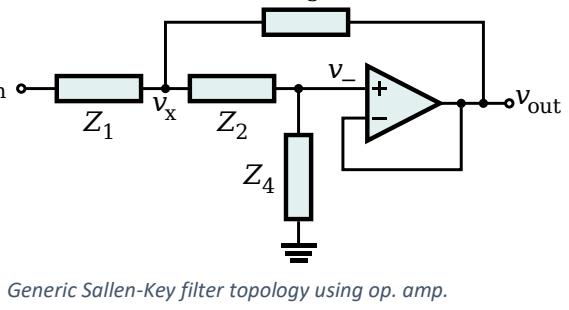
[picture p42: figure]

Because of the complexity of some of these topologies (and in our case probably doesn’t makes any difference) I will try to implement only a few of them.

# Sallen-Key

The first topology that we can implement is the Sallen-Key: for the LP filter we can start (as described in
[24] 3.1) from a single pole section Sallen-Key and add a complex pole Sallen-Key section to obtain the 3° order filter. I then used a calculator to help me solve the equation and get our wanted poles and zeroes in order to have the wanted frequency response.
Same consideration applies for the 1° order HP filter.

The result for the LP with fcl = 100MHz (left) and for the HP with fcℎ = 80MHz (right) is the following:

Example of Tow-Thomas biquad filter topology using op.

Generic Sallen-Key filter topology using op. amp.

After some tests, as seen before, I observed that the HP filter is responsible for falling edge of the gaussian shape in the time domain, while the LP is responsible for the rising edge.
Obviously, we must maintain the band pass width proportion, otherwise the gaussian shape will be distorted. So, as seen before the optimal proportion was 1.9 − 3.3

rad
s

for a frequency response centred in

ωo = 2.57 rad
s

. (HP cut-off is about 0. 739 ∗ ωo and LP cut-off is about 1. 284 ∗ ωo) If we want our gaussian to be 5nS long (about 2nS of FWHM) we can centre our frequency response in about f0 =

1
5∗10⁻⁹ = 200MHz and so have a fcHP ≅ 150MHz and a fcLP ≅ 260MHz.

Here is the Spice simulation result with a pulse (step) of 1nS rising/falling edge and 1mS duration

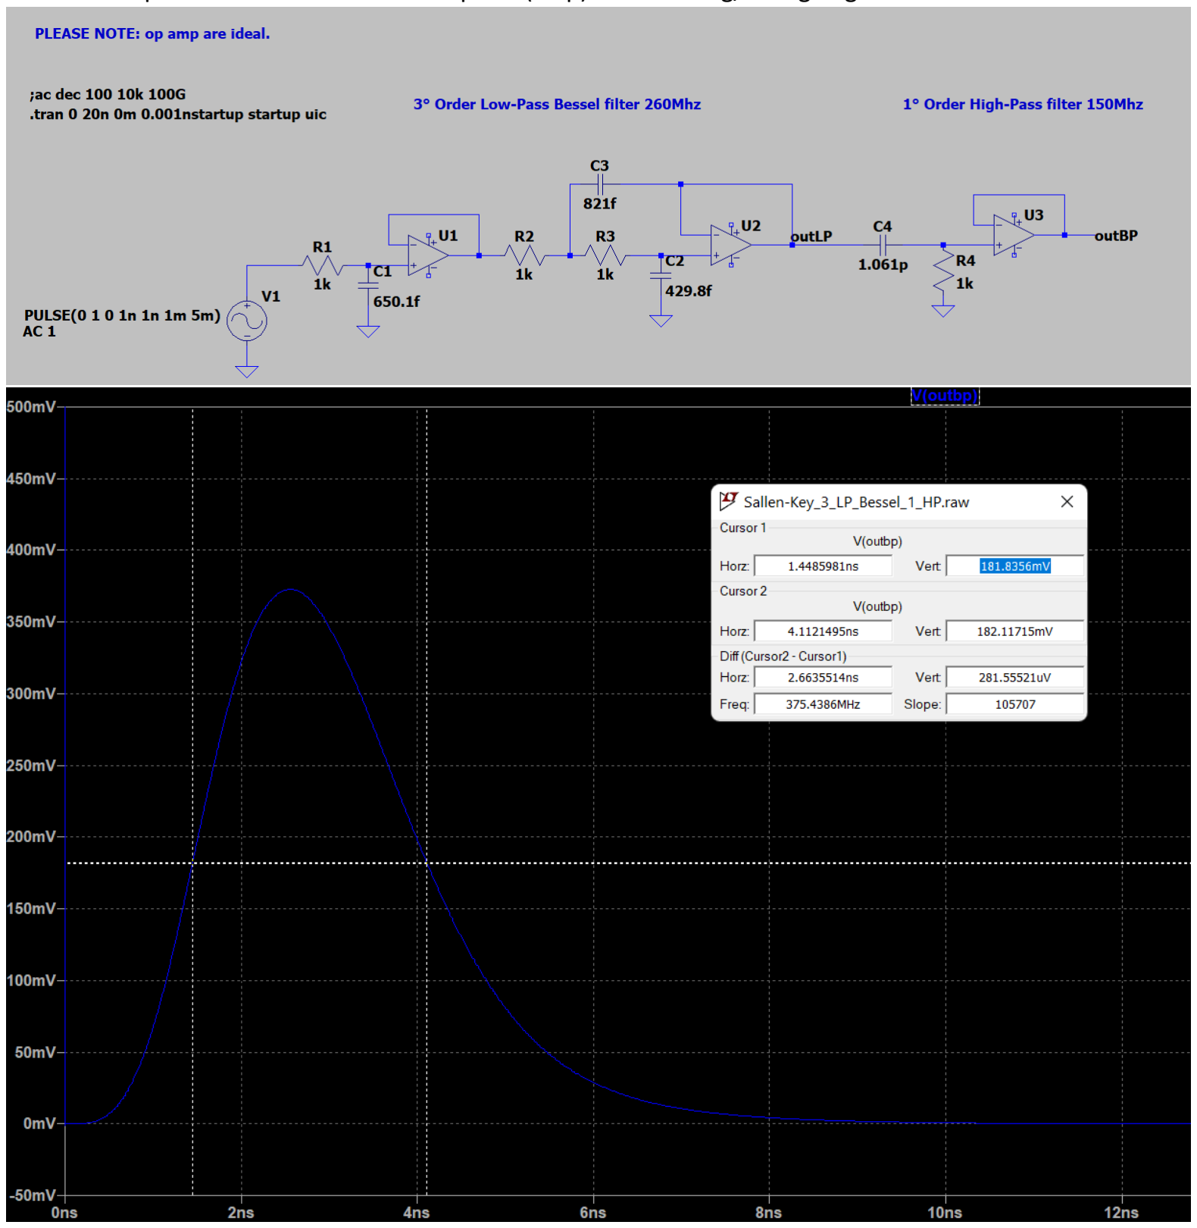
[picture p43: figure]

As we can see results are really good, there is no overshoot at all!
(Note that with some easy tuning I can almost immediately reach 2nS of FWHM.)

# MFB

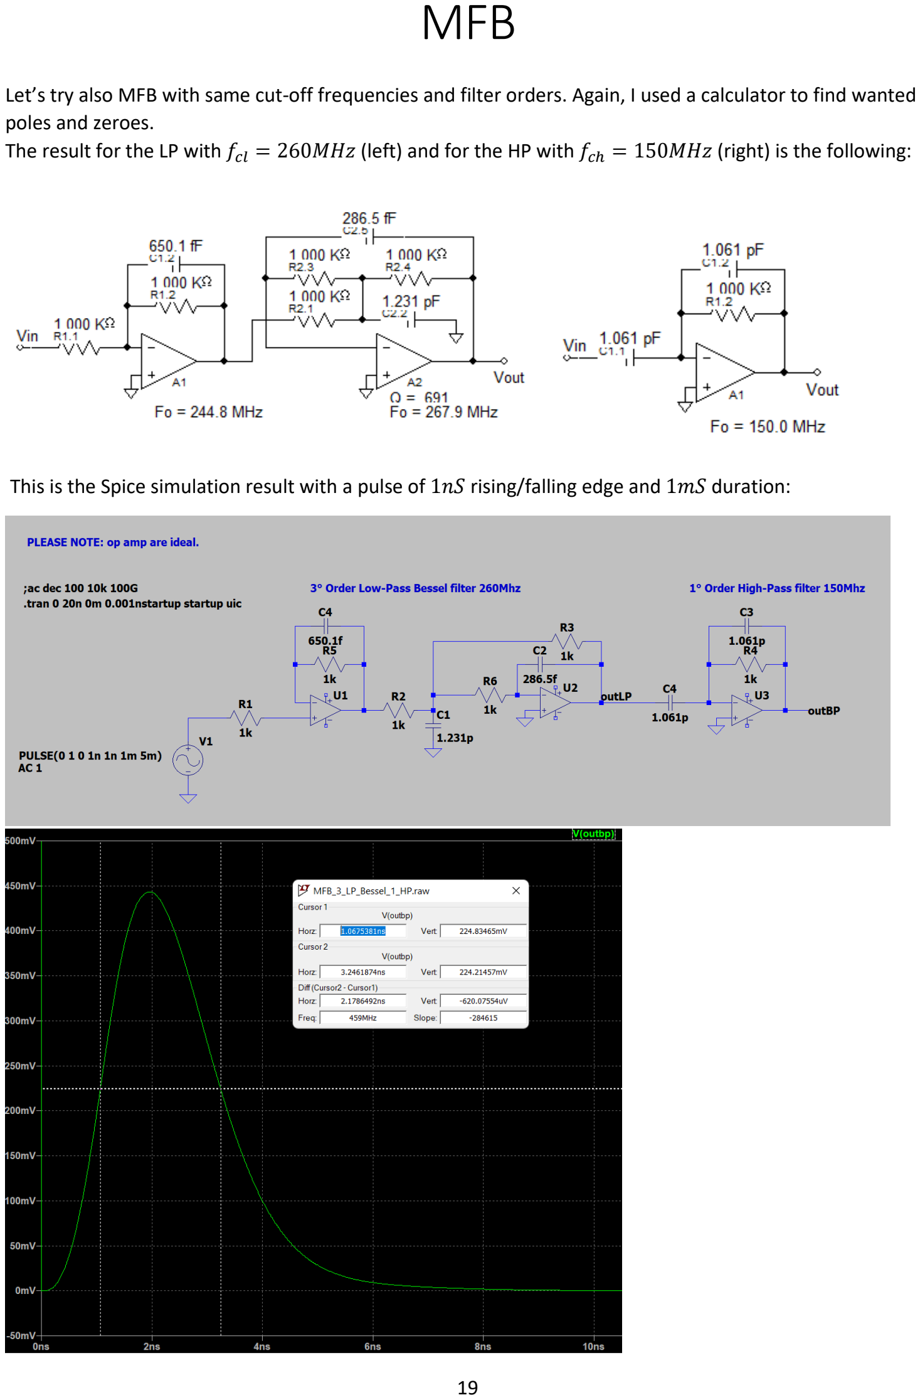
[picture p44: page 20]

Let’s try also MFB with same cut-off frequencies and filter orders. Again, I used a calculator to find wanted poles and zeroes.
The result for the LP with fcl = 260MHz (left) and for the HP with fcℎ = 150MHz (right) is the following:

This is the Spice simulation result with a pulse of 1nS rising/falling edge and 1mS duration:

# Passive ladder

Of course, same result can be obtained with a passive filter, here is the Spice demonstration: (3° Order LP Bessel in the left, 1° Order HP Bessel in the right, cascaded with the help of a buffer)

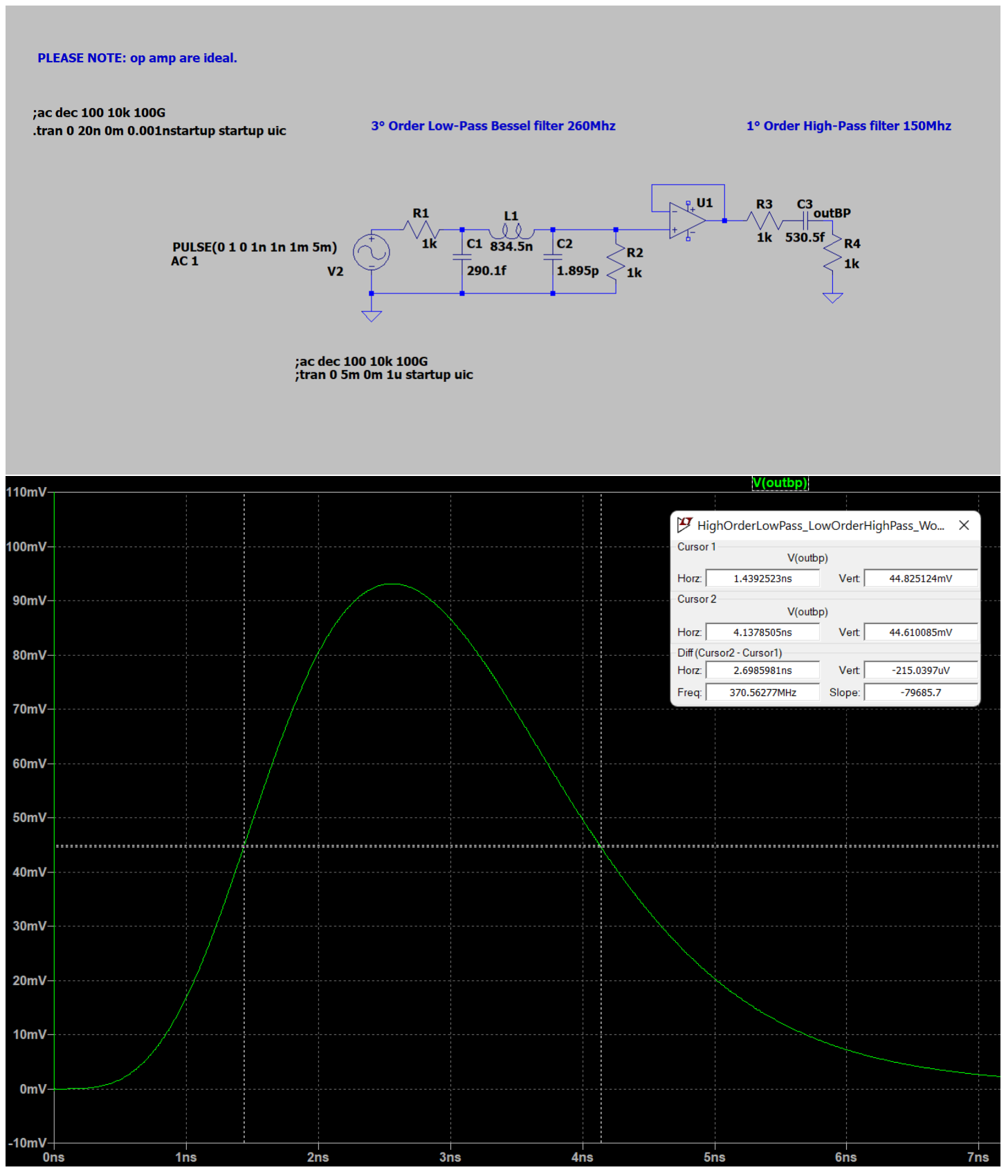
[picture p45: figure]

# A “realsimulation”

Let’s see how these circuits can be implemented in a simulation (with real components) that reflects reality. First we need a high-speed Operational Amplifier like AD8009 by Analog Devices, this is a screenshot from the datasheet:

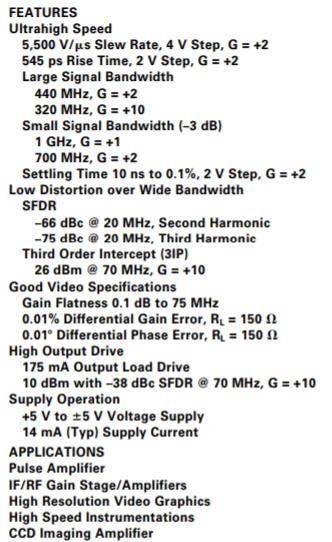
[picture p46: figure]

Next, we must round resistors and capacitors values to the nearest preferred values (we will use E96 series with 1% tolerance). Considering the parasitic capacitance, we better lower the resistors value and increase capacitors value.

PLEASE NOTE: all the previous circuit implementations were calculated with all R = 1Koℎm, so the value of capacitors is probably too small to implement it in reality (parasitic capacitance can easily be in the order of pF or tens of pF), anyway, reducing the value of R can partially solve this problem.

PLEASE NOTE 2: all the previous capacitors and resistors values are calculated values and they need to be rounded to the nearest available commercial value (see E6, E12, E24 etc... series) in order to implement a real circuit.

PLEASE NOTE 3: all the op amps used in previous simulation were ideal op amps (they can work without power supplies, they don’t saturate, they have infinite GBW, infinite Slew Rate, infinite Open Loop Gain and no parasitic capacitances).
Thus, in a real circuit we must consider non-idealities and it can require expensive high speed operational amplifiers as well as low tolerance passive components.

For the simulation I will use the previous discussed Sallen-Key topology.
This is the resulting circuit (note I added a final gain stage because this time input step signal is 100mV):

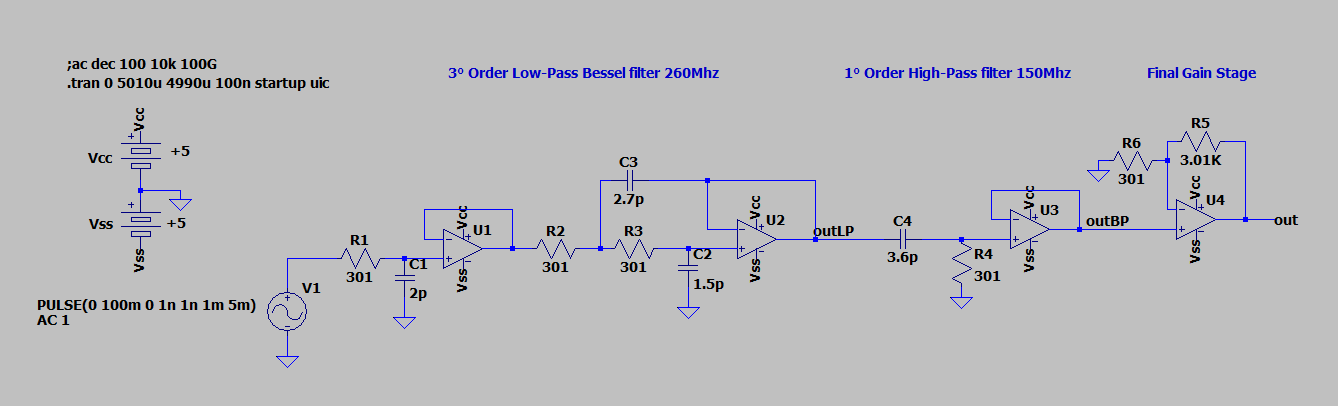
[picture p47: figure]

The result is the following:

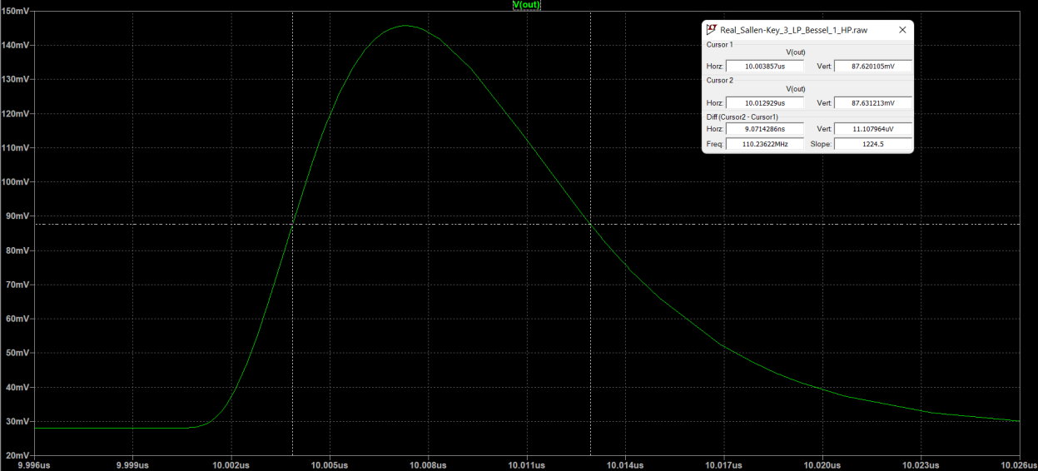
[picture p48: figure]

As we can see, the gaussian shape is a bit distorted because of real Op Amp frequency response, anyway it’s pretty decent. Note that the FWHM is increased and it’s about 9~10 nS and that’s because the GBW of the Op Amp is not sufficient to amplify frequencies above 200MHz.
Note also the offset of about 30mV due to offset voltage and bias currents (it can be easily removed with some precautions like equalling equivalent resistance viewed from input nodes and/or adding trimmers to resistors or just filtering low frequencies at the output of last stage).
This is the frequency response of the circuit above:

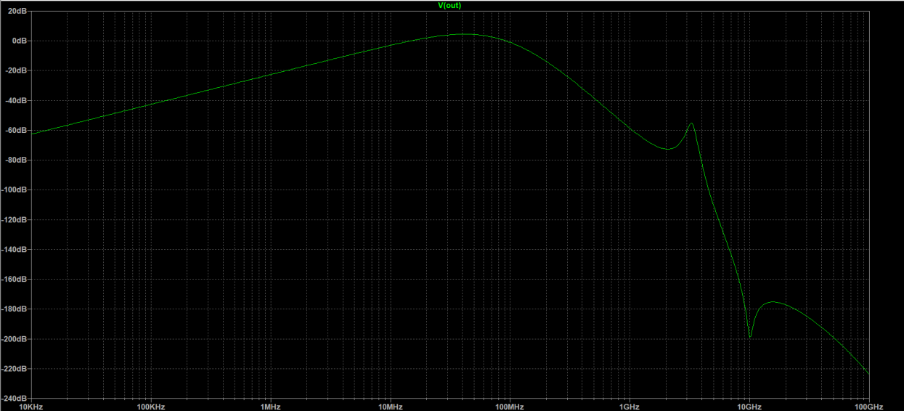
[picture p49: figure]

As we can see this is not our ideal wanted frequency response (even if it’s really close to it) and this is the cause of our time domain gaussian distortion. This is caused of curse by the rounded values of the components and by Op Amps non-idealities.

# Breadboard implementation

I am now ready to set up a test on a breadboard with some real components. Since I haven’t got any high-speed Operational Amplifier or capacitor with value below 10pF I decided to do the test with a longer gaussian shape: about 10µS.

For the operation amplifiers I decided to use a rather old, but also very cheap, good friend: LM358P. Following our previous calculations, f0 =

1
10∗10⁻⁶ = 100KHz, fcHP = 0.739 ∗ f0 ≅ 74KHz and fcLP = 1.284 ∗ f0 ≅ 128KHz.
I used parallel capacitors in order to approximate the calculated capacitance value with my available components. I then modified last Op Amp stage in order to increase Gain.
The resulting schematic is the following:

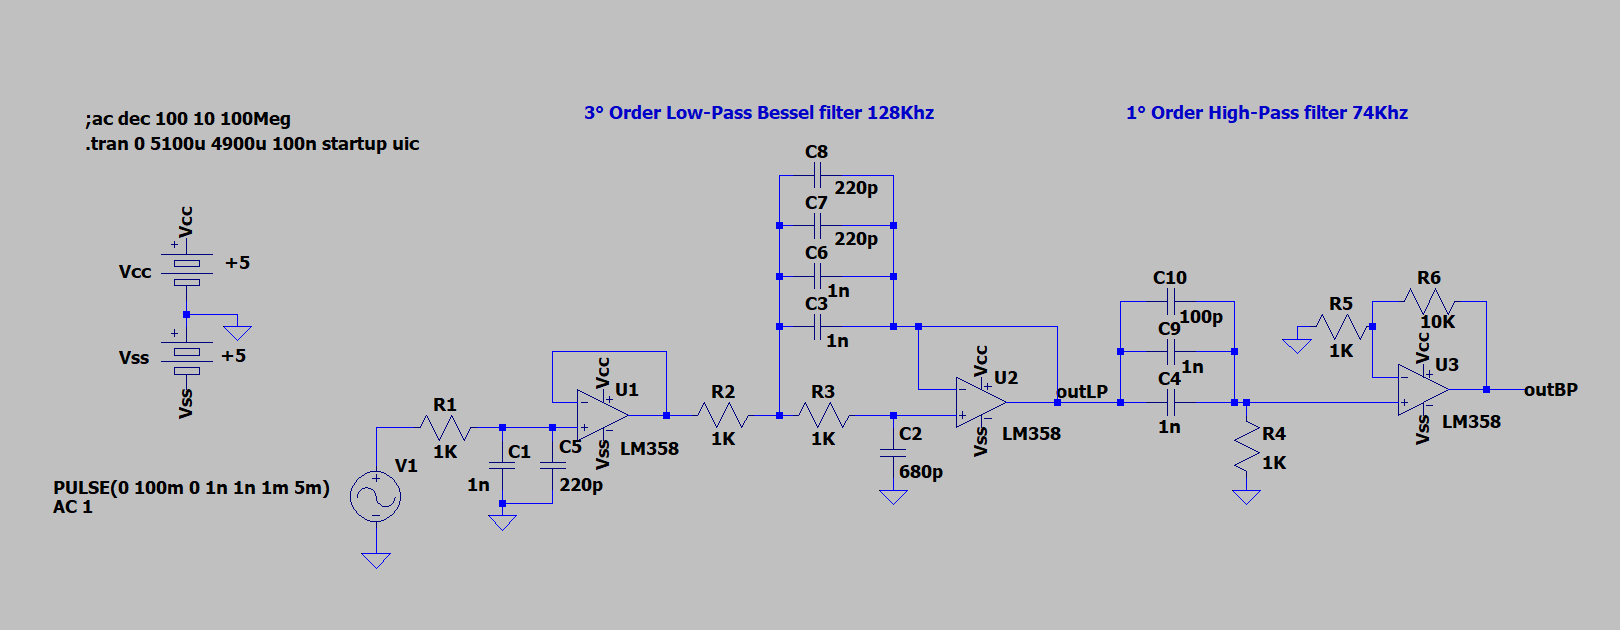
[picture p50: figure]

The result should be more or less like this:

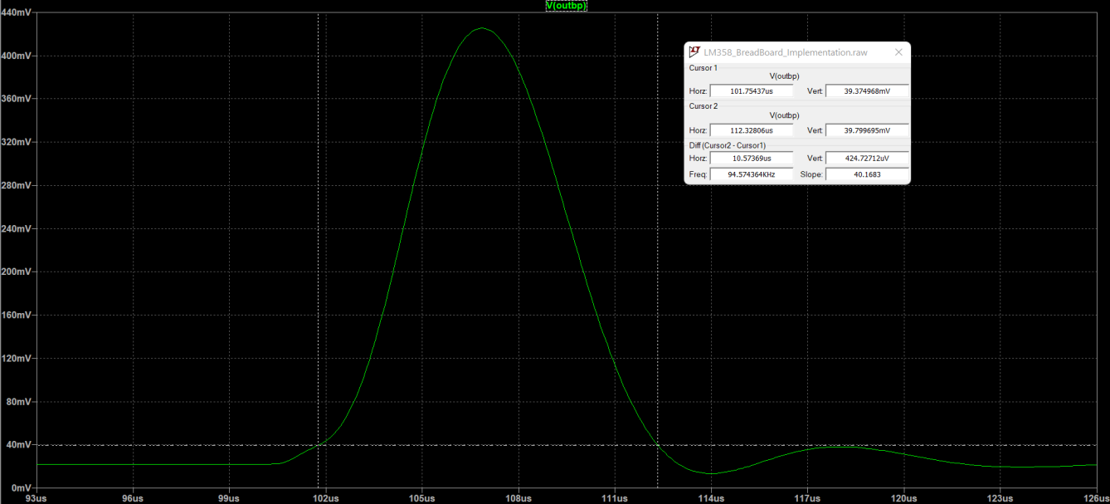
[picture p51: figure]

After some tests, I found out that every Op Amp require a resistor from output to one of the power rails in order to maintain stability (otherwise, due to crossover glitches, it will have small oscillations).
So, the final circuit is the following:

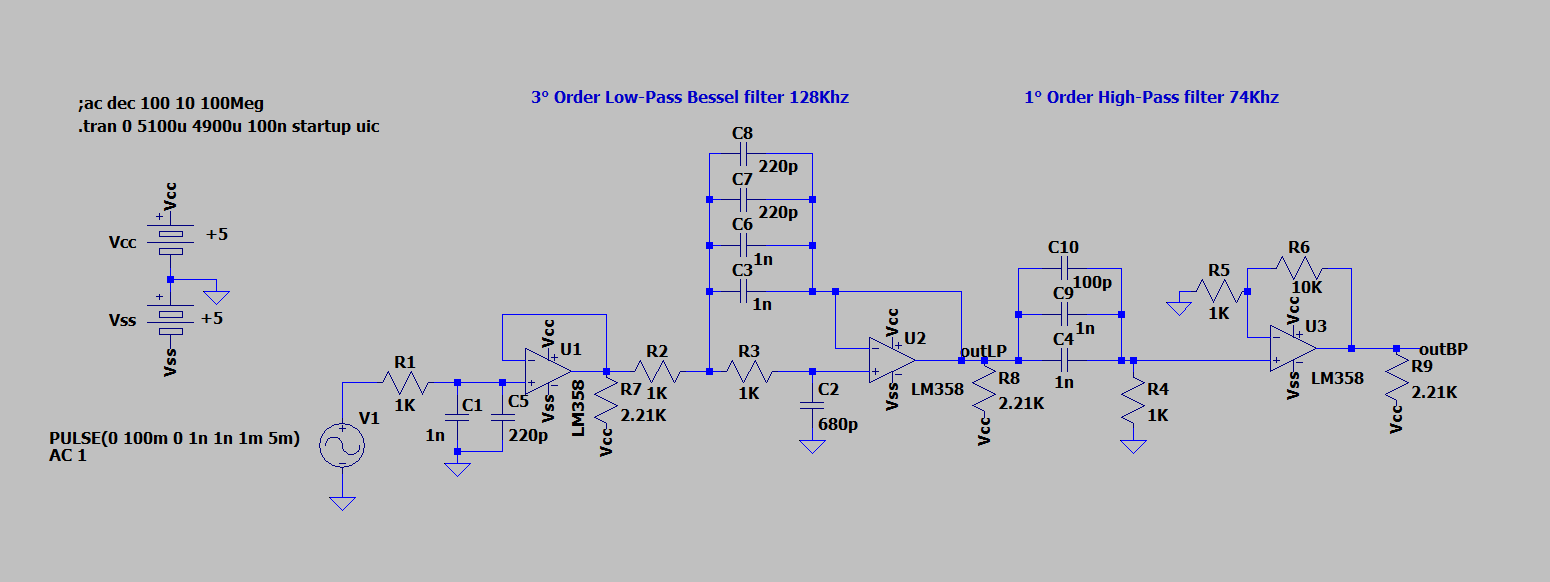
[picture p52: figure]

The setup used for the test was composed by a linear power supply with Vcc = +5V and Vss = −5V for the Op Amp power rails, a signal generator with a Pulse signal of f = 200Hz (5mS period) and Duty Cycle 20% (1mS ON time) with amplitude 100mV and offset 50mV, and a simple oscilloscope:

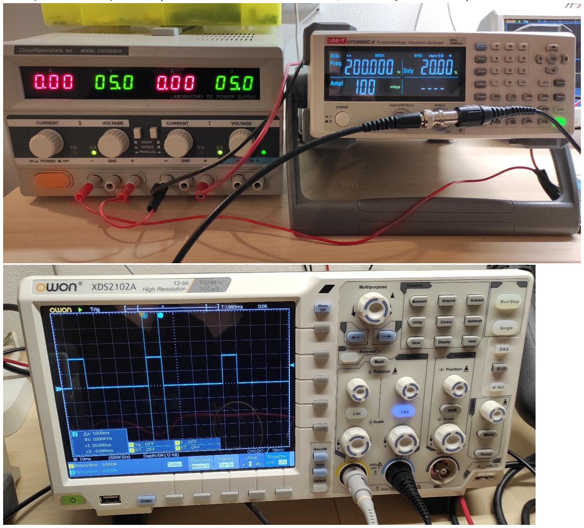
[picture p53: figure]

This is the sketchy circuit mounted on a breadboard:

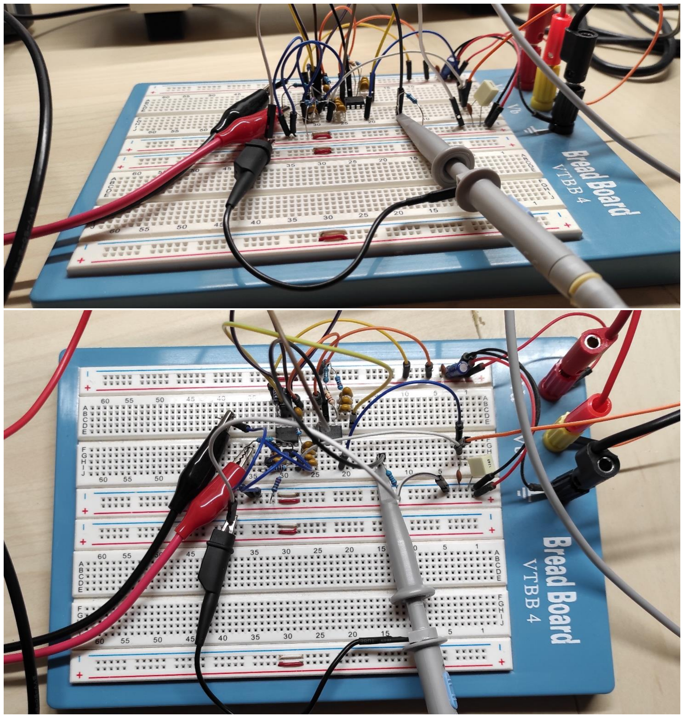
[picture p54: figure]

And finally, this is the output waveform (output signal is yellow, input signal is blue):

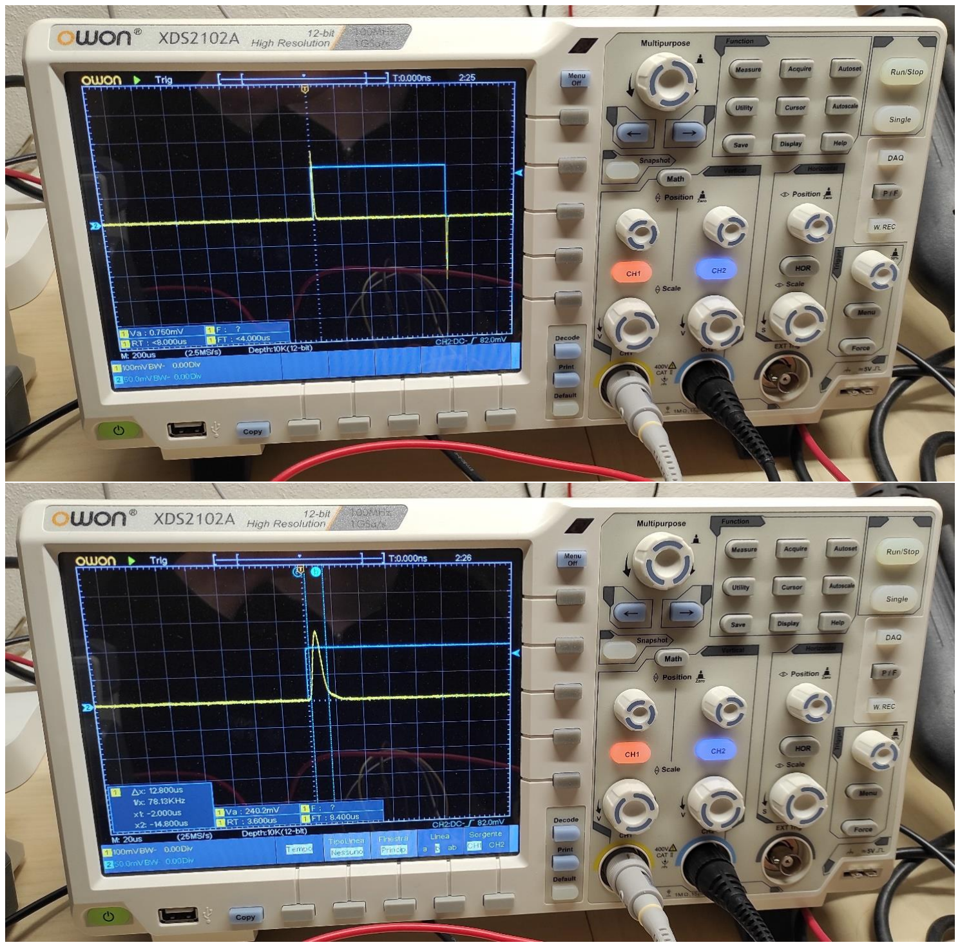
[picture p55: figure]

As we can see, although the low-end components and the sketchy circuit, the result is pretty decent.
The length of the gaussian waveform is about 12~13µS and with some simple adjustments we can shrink it to 10µS.

# Final conclusions

I can finally assert that the discussed method is fully working and, with appropriate components (ASICs/high-speed Op Amps and low tolerance components) and approximations (5° or 8° order), we can even reach gaussian shapes in the order of nS or maybe even below.

## Bibliography

[1] https://en.wikipedia.org/wiki/Pulse_shaping
[2] https://kh6htv.files.wordpress.com/2015/11/an-07a-risetime-filters.pdf
[3] https://en.wikipedia.org/wiki/Gaussian_filter
[4] https://it.wikipedia.org/wiki/Filtro_Sallen-Key
[5] https://en.wikipedia.org/wiki/Filter_(signal_processing)
[6] https://en.wikipedia.org/wiki/Electronic_filter_topology
[7] https://en.wikipedia.org/wiki/Bessel_filter
[8] https://www.analog.com/media/en/training-seminars/design-handbooks/Basic-Linear-Design/Chapter8.pdf (https://www.analog.com/media/en/training-seminars/design-handbooks/Basic-Linear-Design/Chapter8.pdf)
[9] https://en.wikipedia.org/wiki/Impulse_response
[10] https://en.wikipedia.org/wiki/Step_response
[11] https://it.wikipedia.org/wiki/Funzione_di_trasferimento
[12] https://www.dsprelated.com/freebooks/filters/Phase_Group_Delay.html
[13] https://www.rfcafe.com/references/electrical/gaussian-proto-values.htm
[14] https://www.rfcafe.com/references/electrical/gaussian-poles.htm
[15] https://www.sciencedirect.com/science/article/pii/S1434841117305800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 (https://www.sciencedirect.com/science/article/pii/S1434841117305800)
[16] https://www.sciencedirect.com/topics/engineering/bessel-filter
[17] https://en.wikipedia.org/wiki/Electronic_filter_topology
[18]
https://eng.libretexts.org/Bookshelves/Electrical_Engineering/Electronics/Microwave_and_RF_Design_IV%3A_Modules_(Steer)/02%3A_Filters/2.09%3A_Filter_Transformations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 er%20frequency%20of%20the,%CF%892%E2%88%92%CF%891). (https://eng.libretexts.org/Bookshelves/Electrical_Engineering/Electronics/Microwave_and_RF_Design_IV%3A_Modules_(Steer)/02%3A_Filters/2.09%3A_Filter_Transform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)
[19] https://en.wikipedia.org/wiki/Fractional-order_system
[20] https://en.wikipedia.org/wiki/Fractional-order_integrator
[21] https://www.researchgate.net/publication/326275945_Noise_analysis_of_fractional-order_two-integrator_CCII_low-pass_filter_using_Pspice (https://www.researchgate.net/publication/326275945_Noise_analysis_of_fractional-order_two-integrator_CCII_low-pass_filter_using_Pspice)
[22]
https://eng.libretexts.org/Bookshelves/Electrical_Engineering/Electronics/Microwave_and_RF_Design_IV%3A_Modules_(Steer)/02%3A_Filters/2.09%3A_Filter_Transformations (https://eng.libretexts.org/Bookshelves/Electrical_Engineering/Electronics/Microwave_and_RF_Design_IV%3A_Modules_(Steer)/02%3A_Filters/2.09%3A_Filter_Transform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)
[23] https://electronics.stackexchange.com/questions/245766/step-response-of-2nd-order-hpf
[24]
https://www.ti.com/lit/an/sbfa001c/sbfa001c.pdf?ts=1645096937965&ref_url=https%253A%252F %252Fwww.google.sk%252F (https://www.ti.com/lit/an/sbfa001c/sbfa001c.pdf?ts=1645096937965)
[25] https://www.mouser.it/datasheet/2/609/AD8009-1502068.pdf
[26] https://pdf1.alldatasheetit.com/datasheet-pdf/view/22771/STMICROELECTRONICS/LM358P.html
