tollsimy/Analog-Time-Domain-Step-to-Gaussian-Shaping-Filter/Docs/Op-amp Integrator, Operational Amplifier Integrator_files/opamp-opamp29a.gif

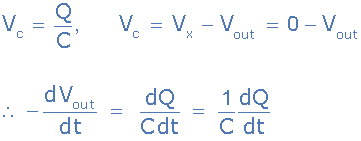
Docs/Op-amp Integrator, Operational Amplifier Integrator_files/opamp-opamp29a.gif
