tollsimy/Analog-Time-Domain-Step-to-Gaussian-Shaping-Filter/Docs/Op-amp Integrator, Operational Amplifier Integrator_files/opamp-opamp34a.gif

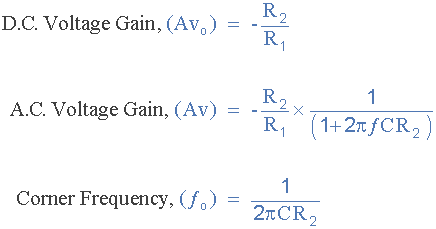
Docs/Op-amp Integrator, Operational Amplifier Integrator_files/opamp-opamp34a.gif
