tollsimy/Analog-Time-Domain-Step-to-Gaussian-Shaping-Filter/LT Spezia/2.1nS_FWHM_Ideal_MFB_3_LP_Bessel_1_HP/MFB_3_LP_Bessel_1_HP.asc

C1: cap; 1.231p
C2: cap; 286.5f
C3: cap; 1.061p
C4: cap; 1.061p
C4: cap; 650.1f
R1: res; 1k
R2: res; 1k
R3: res; 1k
R4: res; 1k
R5: res; 1k
R6: res; 1k
U1: UniversalOpamp2; Avol=100G GBW=10000G Slew=1000G
U2: UniversalOpamp2; Avol=100G GBW=10000G Slew=1000G
U3: UniversalOpamp2; Avol=100G GBW=10000G Slew=1000G
V1: signal; PULSE(0 1 0 1n 1n 1m 5m); AC 1
Named nets: 0, outLP, outBP
;ac dec 100 10k 100G
.tran 0 20n 0m 0.001nstartup startup uic
3° Order Low-Pass Bessel filter 260Mhz
1° Order High-Pass filter 150Mhz
PLEASE NOTE: op amp are ideal.
