tollsimy/Analog-Time-Domain-Step-to-Gaussian-Shaping-Filter/LT Spezia/2.6nS_FWHM_Passive_3_LP_Bessel_1_HP/Passive_3_LP_Bessel_1_HP.asc

C1: cap; 290.1f
C2: cap; 1.895p
C3: cap; 530.5f
L1: ind; 834.5n
R1: res; 1k
R2: res; 1k
R3: res; 1k
R4: res; 1k
U1: UniversalOpamp2; Avol=100G GBW=10000G Slew=1000G
V2: signal; PULSE(0 1 0 1n 1n 1m 5m); AC 1
Named nets: 0, outBP
;ac dec 100 10k 100G
;tran 0 5m 0m 1u startup uic
;ac dec 100 10k 100G
.tran 0 20n 0m 0.001nstartup startup uic
3° Order Low-Pass Bessel filter 260Mhz
1° Order High-Pass filter 150Mhz
PLEASE NOTE: op amp are ideal.
