tollsimy/Analog-Time-Domain-Step-to-Gaussian-Shaping-Filter/LT Spezia/7nS_Bad_Real_Passive_8_LP_Bessel_1_HP/Real_Passive_8_LP_Bessel_1_HP.asc

C1: cap; 3.6p; V=25 Irms=0 Rser=0 Lser=0 mfg="Murata" pn="GRM0335C1E3R6CA01" type="C0G"
C6: cap; 1000f; V=25 Irms=0 Rser=0 Lser=0 mfg="Murata" pn="GRM0335C1E1R0CA01" type="C0G"
C7: cap; 1000f; V=25 Irms=0 Rser=0 Lser=0 mfg="Murata" pn="GRM0335C1E1R0CA01" type="C0G"
C8: cap; 1.5p; V=25 Irms=0 Rser=0 Lser=0 mfg="Murata" pn="GCM0335C1E1R5CA16" type="C0G"
C9: cap; 2.2p; V=16 Irms=0 Rser=0.374271 Lser=239.727p mfg="Würth Elektronik" pn="885012005021 WCAP-CSGP 0402" type="NP0"
L5: ind; 100n; Ipk=4 Rser=0.015 Rpar=0 Cpar=0 mfg="Murata" pn="LQM2MPZR10MJHL"
L6: ind; 100n; Ipk=4 Rser=0.015 Rpar=0 Cpar=0 mfg="Murata" pn="LQM2MPZR10MJHL"
L7: ind; 150n; Ipk=6.2 Rser=0.012 Rpar=0 Cpar=0 mfg="Murata" pn="DFE201612PD-R15M=P2"
L8: ind; 390n; Ipk=0.3 Rser=0.6 Rpar=36.738 Cpar=0 mfg="Coilcraft" pn="0402AF-391"
R1: res; 301; tol=1 pwr=0.1
R3: res; 301; tol=1 pwr=0.1
R5: res; 3.01K; tol=1 pwr=0.1
R6: res; 301; tol=1 pwr=0.1
R7: res; 301; tol=1 pwr=0.1
U1: AD8009an
U4: AD8009an
V1: signal; PULSE(0 1 0 1n 1n 1m 5m); AC 1
Vcc: battery; +5
Vss: battery; +5
Named nets: 0, outBP, Vcc, Vss, out
;ac dec 100 10k 100G
.tran 0 5010u 4990u 100n startup uic
8° Order Low-Pass Bessel filter 260Mhz
1° Order High-Pass filter 150Mhz
Final Gain Stage
