tollsimy/Analog-Time-Domain-Step-to-Gaussian-Shaping-Filter/LT Spezia/9nS_Real_Sallen-Key_3_LP_Bessel_1_HP/Real_Sallen-Key_3_LP_Bessel_1_HP.asc

C1: cap; 2p; V=25 Irms=0 Rser=0 Lser=0 mfg="Murata" pn="GCM0335C1E2R0CA16" type="C0G"
C2: cap; 1.5p; V=25 Irms=0 Rser=0 Lser=0 mfg="Murata" pn="GRM0335C1E1R5CA01" type="C0G"
C3: cap; 2.7p; V=25 Irms=0 Rser=0 Lser=0 mfg="Murata" pn="GCM0335C1E2R7CA16" type="C0G"
C4: cap; 3.6p; V=25 Irms=0 Rser=0 Lser=0 mfg="Murata" pn="GRM0335C1E3R6CA01" type="C0G"
R1: res; 301; tol=1 pwr=0.1
R2: res; 301; tol=1 pwr=0.1
R3: res; 301; tol=1 pwr=0.1
R4: res; 301; tol=1 pwr=0.1
R5: res; 3.01K; tol=1 pwr=0.1
R6: res; 301; tol=1 pwr=0.1
U1: AD8009an
U2: AD8009an
U3: AD8009an
U4: AD8009an
V1: signal; PULSE(0 100m 0 1n 1n 1m 5m); AC 1
Vcc: battery; +5
Vss: battery; +5
Named nets: 0, outLP, outBP, Vcc, Vss, out
.ac dec 100 10k 100G
;tran 0 5010u 4990u 100n startup uic
3° Order Low-Pass Bessel filter 260Mhz
1° Order High-Pass filter 150Mhz
Final Gain Stage
