tollsimy/Analog-Time-Domain-Step-to-Gaussian-Shaping-Filter/LT Spezia/LM358_BreadBoard_Implementation/LM358_BreadBoard_Implementation.asc

C1: cap; 1n; V=25 Irms=0 Rser=0.23112 Lser=501.24p mfg="Würth Elektronik" pn="885012208046 WCAP-CSGP 1206" type="X7R"
C2: cap; 680p; V=25 Irms=0 Rser=0.32598 Lser=652.7p mfg="Würth Elektronik" pn="885012208045 WCAP-CSGP 1206" type="X7R"
C3: cap; 1n; V=25 Irms=0 Rser=0.23112 Lser=501.24p mfg="Würth Elektronik" pn="885012208046 WCAP-CSGP 1206" type="X7R"
C4: cap; 1n; V=25 Irms=0 Rser=0.23112 Lser=501.24p mfg="Würth Elektronik" pn="885012208046 WCAP-CSGP 1206" type="X7R"
C5: cap; 220p; V=6.3 Irms=5.76m Rser=19.9214 Lser=0 mfg="KEMET" pn="C0805C221K9RAC" type="X7R"
C6: cap; 1n; V=25 Irms=0 Rser=0.23112 Lser=501.24p mfg="Würth Elektronik" pn="885012208046 WCAP-CSGP 1206" type="X7R"
C7: cap; 220p; V=25 Irms=0 Rser=0.115723 Lser=436.176p mfg="Würth Elektronik" pn="885012007036 WCAP-CSGP 0805" type="NP0"
C8: cap; 220p; V=25 Irms=0 Rser=0.115723 Lser=436.176p mfg="Würth Elektronik" pn="885012007036 WCAP-CSGP 0805" type="NP0"
C9: cap; 1n; V=25 Irms=0 Rser=0.23112 Lser=501.24p mfg="Würth Elektronik" pn="885012208046 WCAP-CSGP 1206" type="X7R"
C10: cap; 100p; V=10 Irms=0 Rser=0.88264 Lser=318.58p mfg="Würth Elektronik" pn="885012207004 WCAP-CSGP 0805" type="X7R"
R1: res; 1K; tol=1 pwr=0.1
R2: res; 1K; tol=1 pwr=0.1
R3: res; 1K; tol=1 pwr=0.1
R4: res; 1K; tol=1 pwr=0.1
R5: res; 1K; tol=1 pwr=0.1
R6: res; 10K; tol=1 pwr=0.1
R7: res; 2.21K; tol=1 pwr=0.1
R8: res; 2.21K; tol=1 pwr=0.1
R9: res; 2.21K; tol=1 pwr=0.1
U1: LM358
U2: LM358
U3: LM358
V1: signal; PULSE(0 100m 0 1n 1n 1m 5m); AC 1
Vcc: battery; +5
Vss: battery; +5
Named nets: 0, outLP, outBP, Vcc, Vss
;ac dec 100 10 100Meg
.tran 0 5100u 4900u 100n startup uic
3° Order Low-Pass Bessel filter 128Khz
1° Order High-Pass filter 74Khz
