tollsimy/Analog-Time-Domain-Step-to-Gaussian-Shaping-Filter/LT Spezia/RC Ladder/RC Ladder filter.asc

C1: cap; 4.033u
C2: cap; 8.964u
C3: cap; 19.477u
C4: cap; 57.566u
C5: cap; 408u
C11: cap; 4.033u
C12: cap; 8.964u
C13: cap; 19.477u
C14: cap; 57.566u
C15: cap; 408u
R0: res; 3.9928k
R1: res; 1.4538k
R2: res; 4.6372k
R3: res; 7.2915k
R4: res; 8.0789k
R5: res; 6.1943k
R6: res; 1.59k
R7: res; 1.56k
R14: res; 3.9928k
R15: res; 1.4538k
R16: res; 4.6372k
R17: res; 7.2915k
R18: res; 8.0789k
R19: res; 6.1943k
V1: signal; AC 1
V2: signal; AC 1
Named nets: 0
1HZ
rzero_fii =
 
   3.9928e+03
 
 
r_fii =
 
   1.4538e+03
 
 
c_fii =
 
   4.0329e-06
 
 
r_fii =
 
   4.6372e+03
 
 
c_fii =
 
   8.9644e-06
 
 
r_fii =
 
   7.2915e+03
 
 
c_fii =
 
   1.9477e-05
 
 
r_fii =
 
   8.0789e+03
 
 
c_fii =
 
   5.7566e-05
 
 
r_fii =
 
   6.1943e+03
 
 
c_fii =
 
   4.0821e-04
.ac dec 100 0.01 10k
